emfcamp/TiDAL-Hardware/tilda6/manufacturing-data-expansion/expansion-back.png

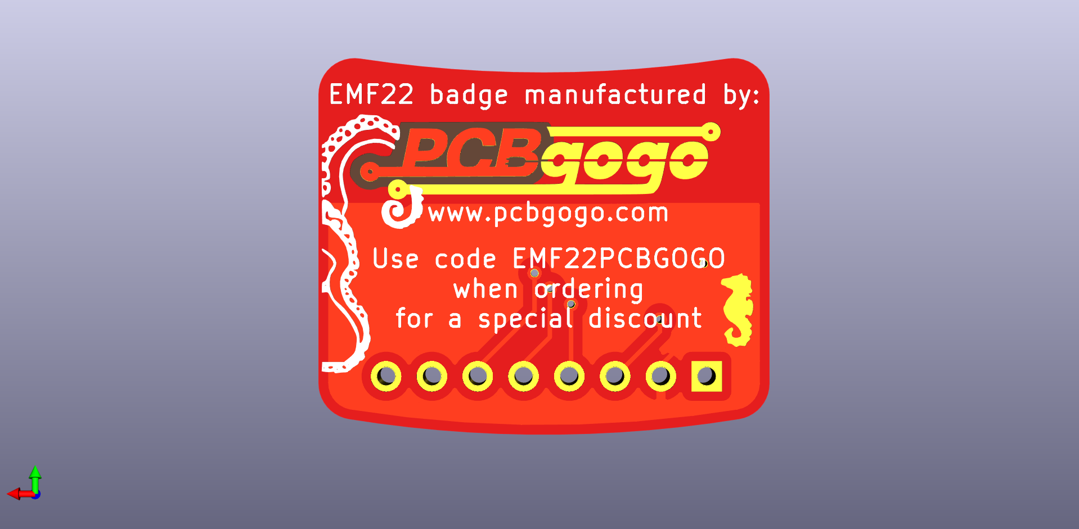
tilda6/manufacturing-data-expansion/expansion-back.png
