emfcamp/TiDAL-Hardware/tilda6/manufacturing-data-expansion/expansion-front.png

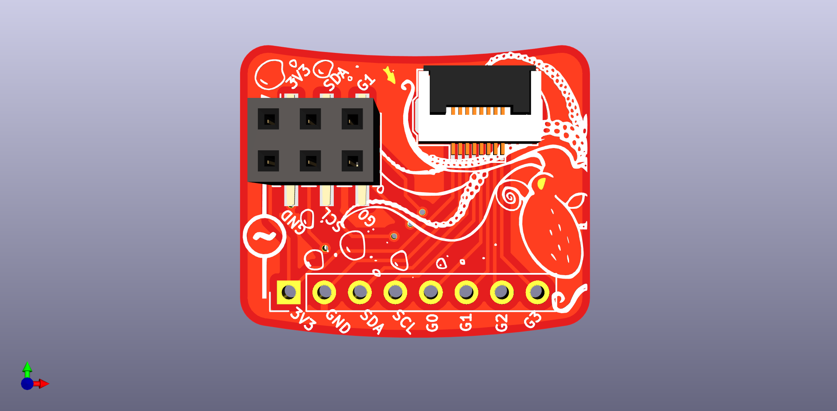
tilda6/manufacturing-data-expansion/expansion-front.png
