emfcamp/TiDAL-Hardware/art/bottom.png

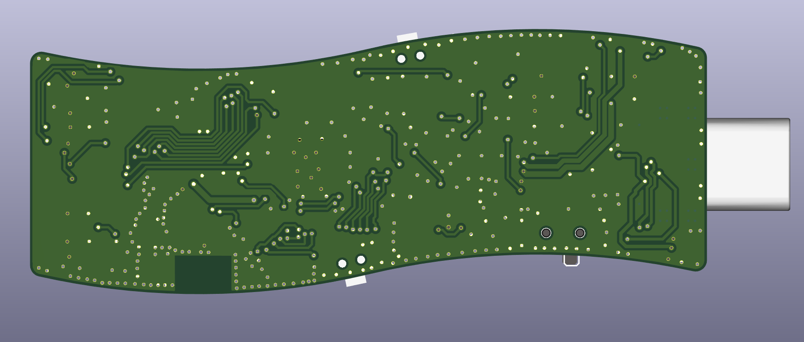
art/bottom.png
