emfcamp/TiDAL-Hardware/art/features/bot-front/bot-front-mask.png

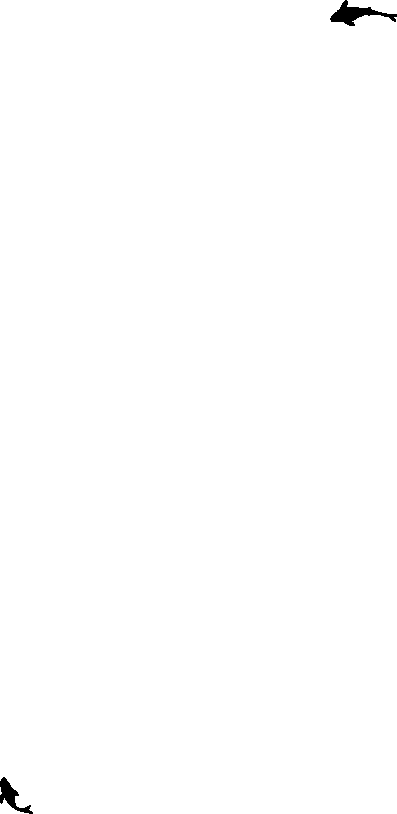
art/features/bot-front/bot-front-mask.png
