emfcamp/TiDAL-Hardware/art/features/bot-front/bot-front-silk.png

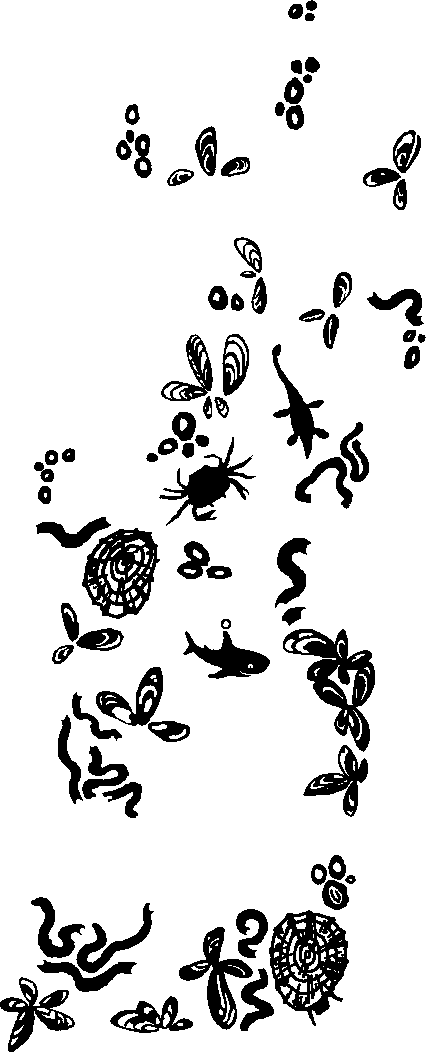
art/features/bot-front/bot-front-silk.png
