emfcamp/TiDAL-Hardware/art/features/bot-reverse/bf2.png

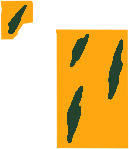
art/features/bot-reverse/bf2.png
