emfcamp/TiDAL-Hardware/art/features/bot-reverse/bf3.png

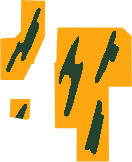
art/features/bot-reverse/bf3.png
