emfcamp/TiDAL-Hardware/art/features/bot-reverse/bf4.png

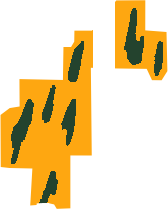
art/features/bot-reverse/bf4.png
