emfcamp/TiDAL-Hardware/art/features/bot-reverse/bf6.png

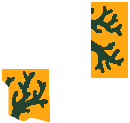
art/features/bot-reverse/bf6.png
