emfcamp/TiDAL-Hardware/art/features/bot-reverse/bf7.png

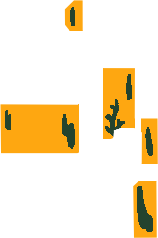
art/features/bot-reverse/bf7.png
