emfcamp/TiDAL-Hardware/art/features/bot-reverse/bot-reverse-mask.png

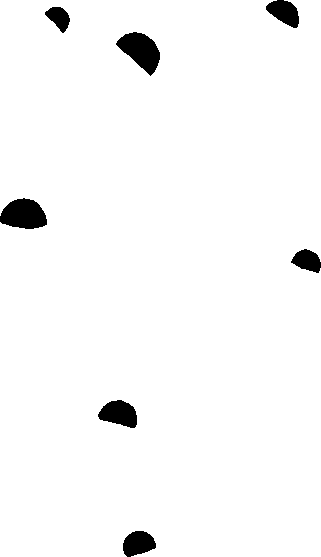
art/features/bot-reverse/bot-reverse-mask.png
