emfcamp/TiDAL-Hardware/art/features/bot-reverse/bot-reverse-silk.png

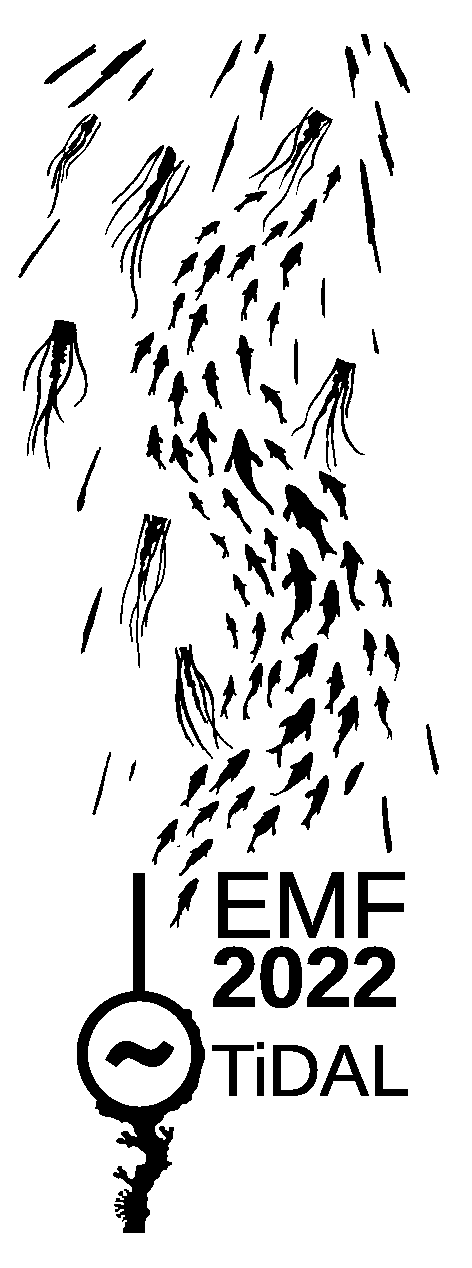
art/features/bot-reverse/bot-reverse-silk.png
