emfcamp/TiDAL-Hardware/art/features/top-front/f3.png

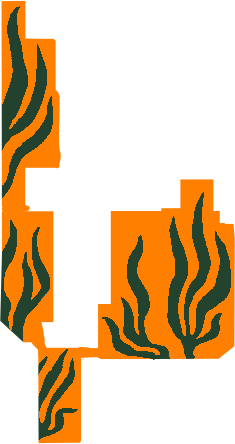
art/features/top-front/f3.png
