emfcamp/TiDAL-Hardware/art/features/top-front/front-silk.png

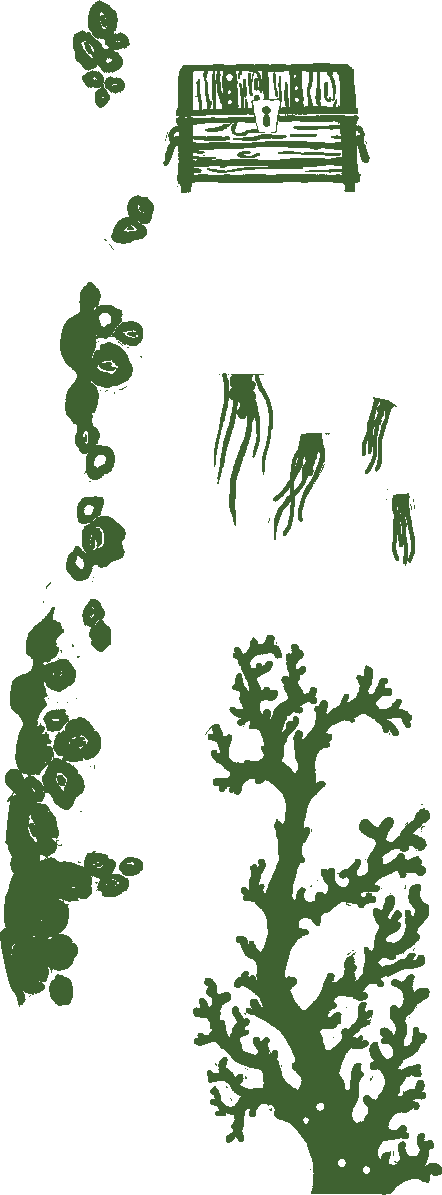
art/features/top-front/front-silk.png
