emfcamp/TiDAL-Hardware/art/features/top-front/top-front-image.png

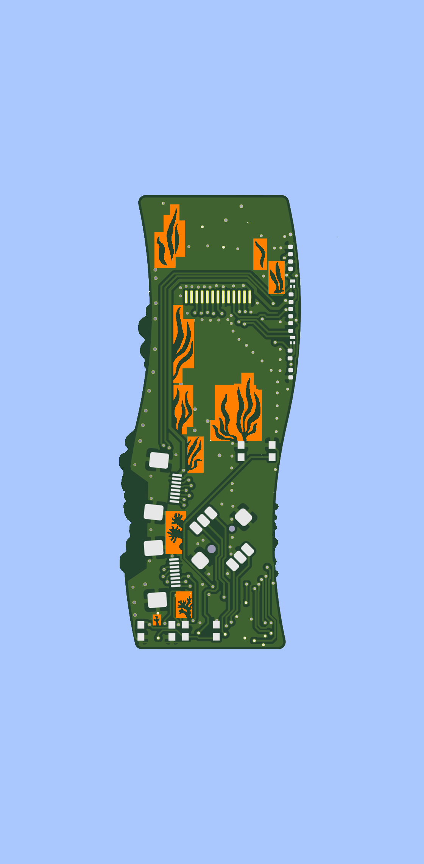
art/features/top-front/top-front-image.png
