emfcamp/TiDAL-Hardware/art/features/top-front/top-front-mask.png

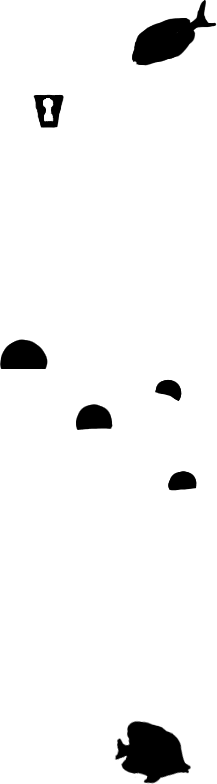
art/features/top-front/top-front-mask.png
