emfcamp/TiDAL-Hardware/art/features/top-front/topfront-silk.png

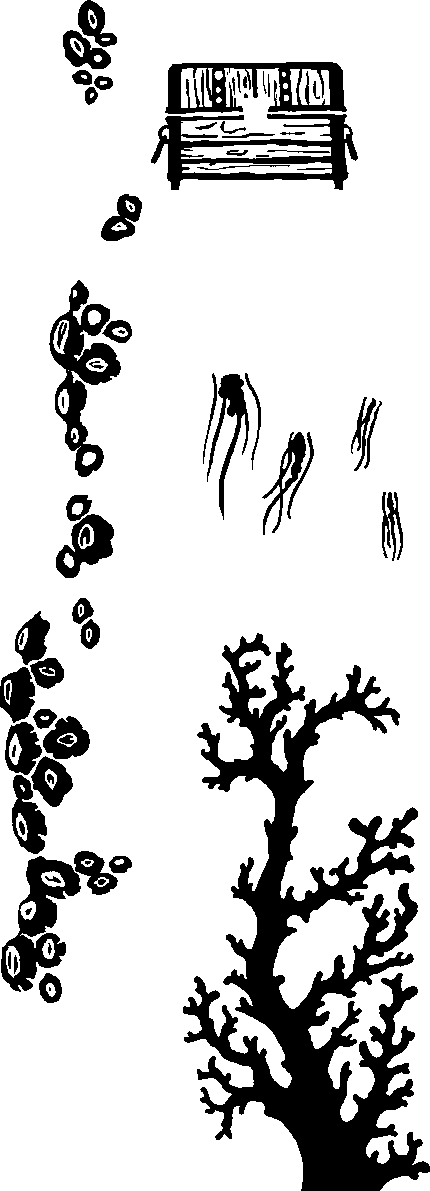
art/features/top-front/topfront-silk.png
