emfcamp/TiDAL-Hardware/art/features/top-reverse/top-reverse-mask.png

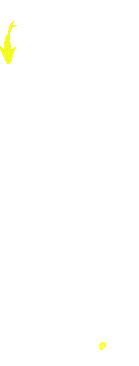
art/features/top-reverse/top-reverse-mask.png
