emfcamp/TiDAL-Hardware/art/features/top-reverse/top-reverse-silk.png

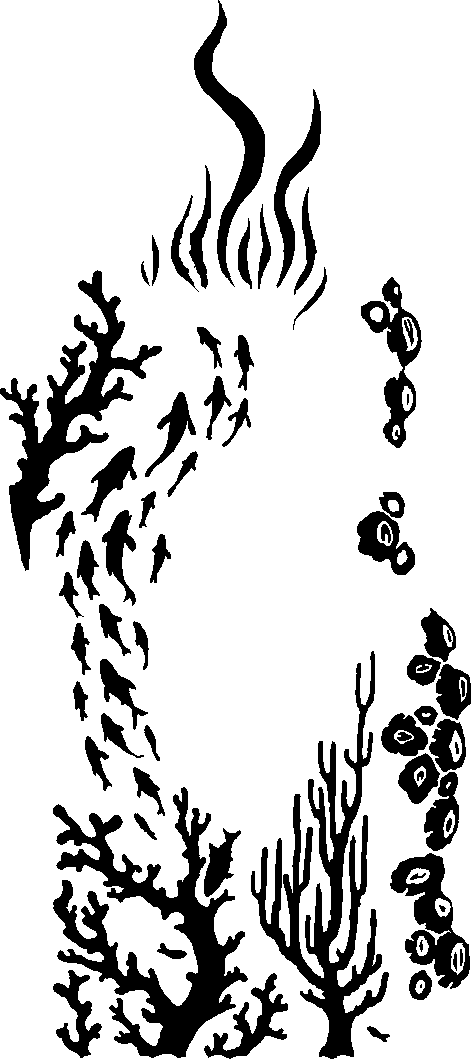
art/features/top-reverse/top-reverse-silk.png
