emfcamp/TiDAL-Hardware/art/features/top-reverse/tr1.png

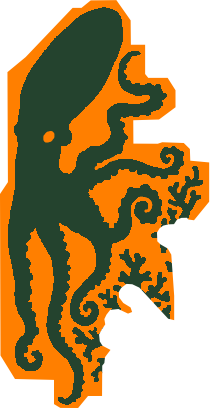
art/features/top-reverse/tr1.png
