emfcamp/TiDAL-Hardware/art/overview.png

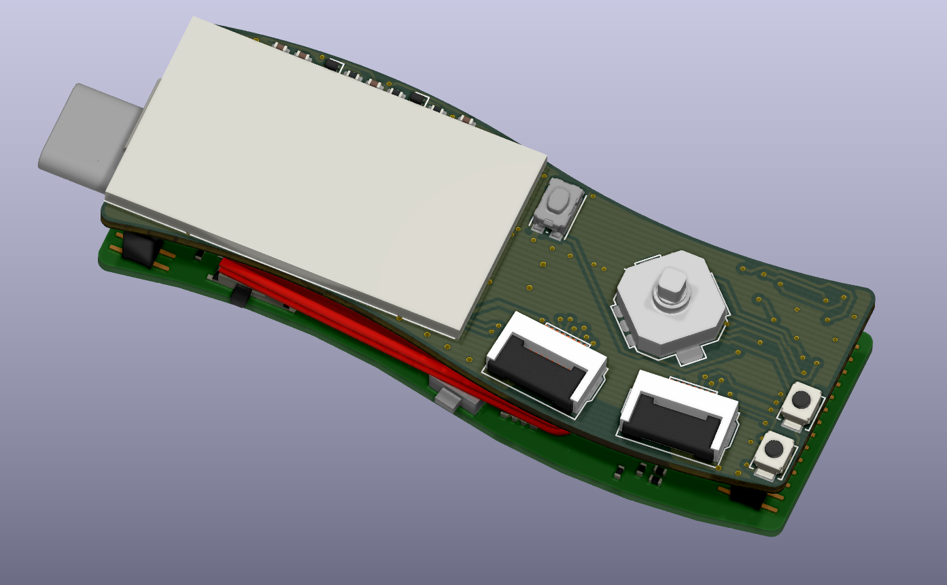
art/overview.png
