emfcamp/TiDAL-Hardware/art/tilda6-bot-noparts-reverse.png

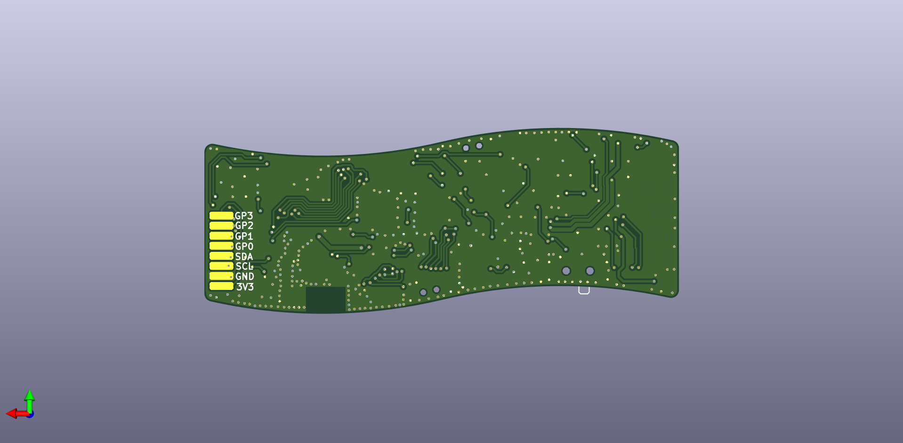
art/tilda6-bot-noparts-reverse.png
