emfcamp/TiDAL-Hardware/art/tilda6-bot-noparts.png

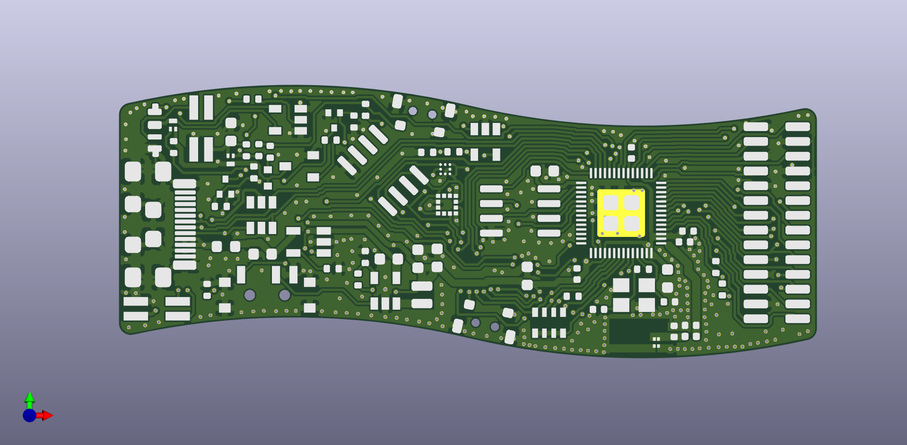
art/tilda6-bot-noparts.png
