emfcamp/TiDAL-Hardware/art/tilda6-bot-nosilk.png

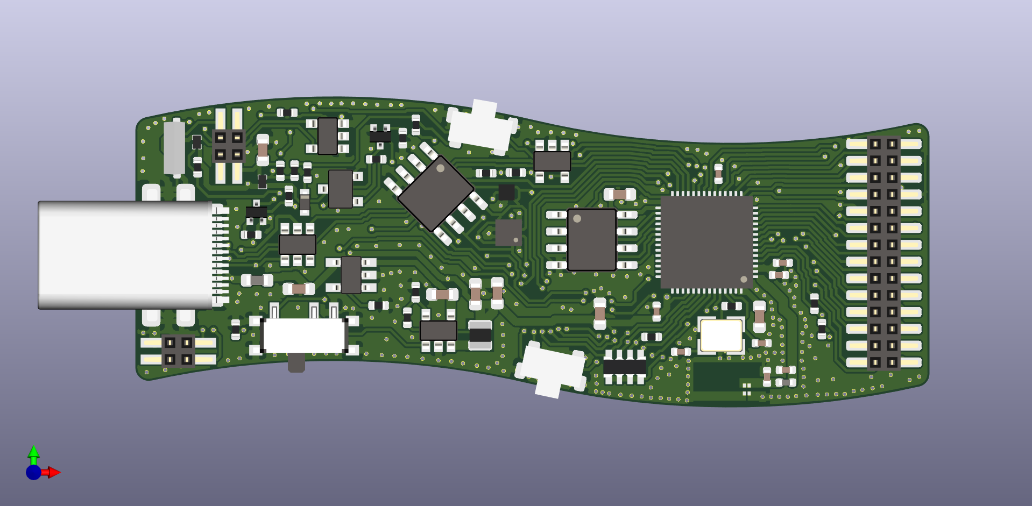
art/tilda6-bot-nosilk.png
