emfcamp/TiDAL-Hardware/art/tilda6-bottomboard-botside-annotated-mask.png

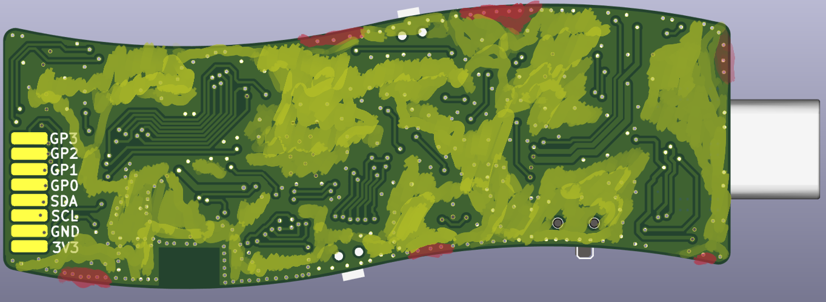
art/tilda6-bottomboard-botside-annotated-mask.png
