emfcamp/TiDAL-Hardware/art/tilda6-bottomboard-botside-annotated.png

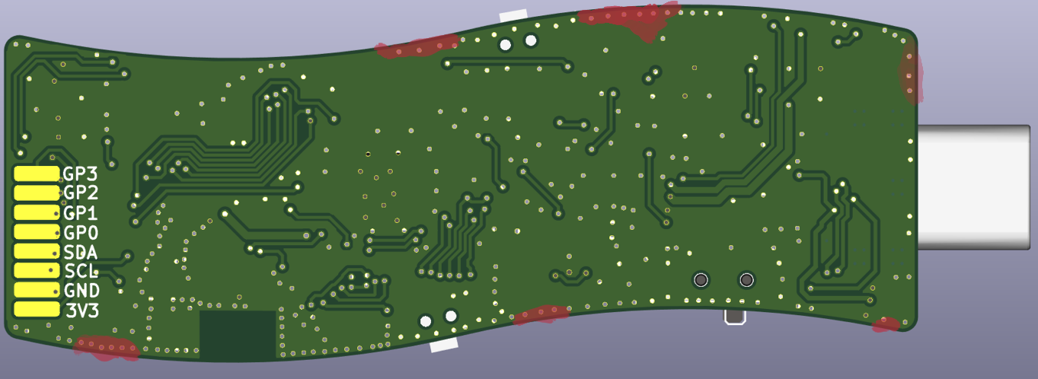
art/tilda6-bottomboard-botside-annotated.png
