emfcamp/TiDAL-Hardware/art/tilda6-bottomboard-topside-annotated-mask.png

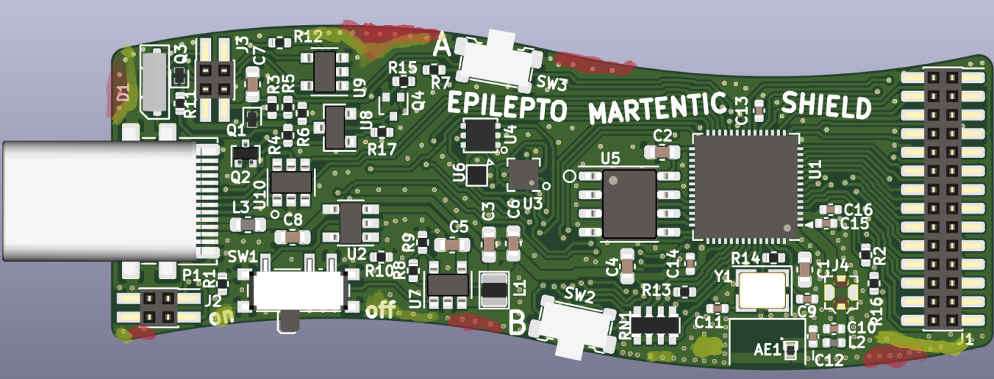
art/tilda6-bottomboard-topside-annotated-mask.png
