emfcamp/TiDAL-Hardware/art/tilda6-top-noparts-reverse.png

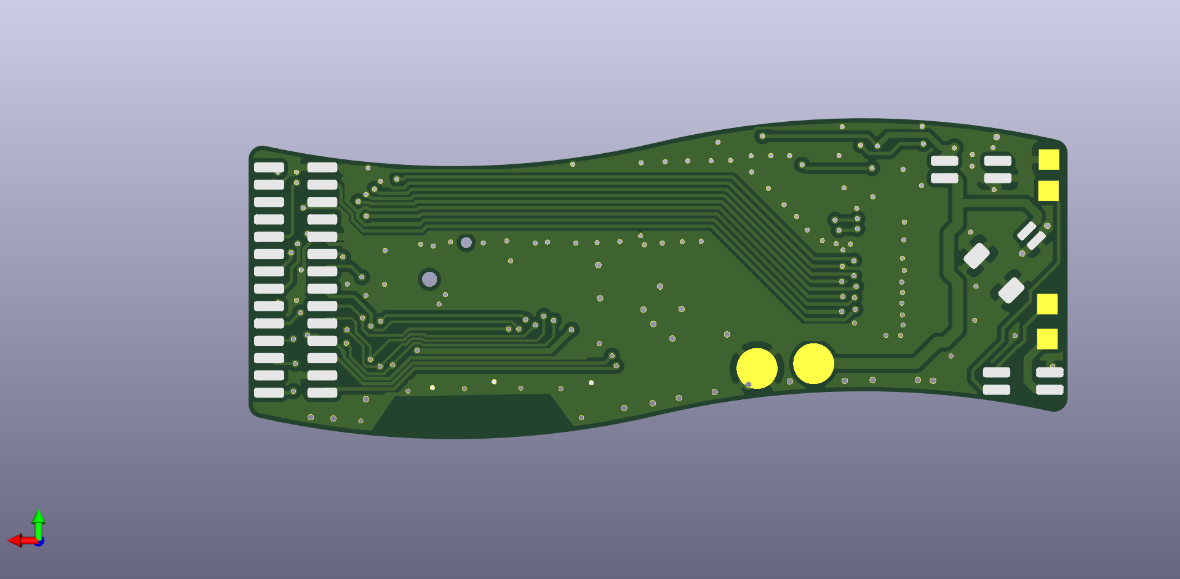
art/tilda6-top-noparts-reverse.png
