emfcamp/TiDAL-Hardware/art/tilda6-top-noparts.png

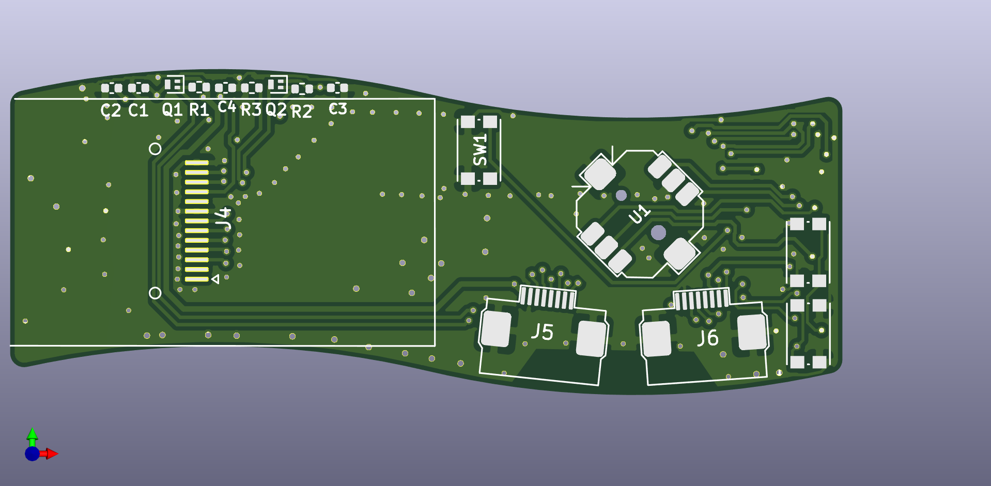
art/tilda6-top-noparts.png
