emfcamp/TiDAL-Hardware/art/tilda6-topboard-botside-annotated-mask.png

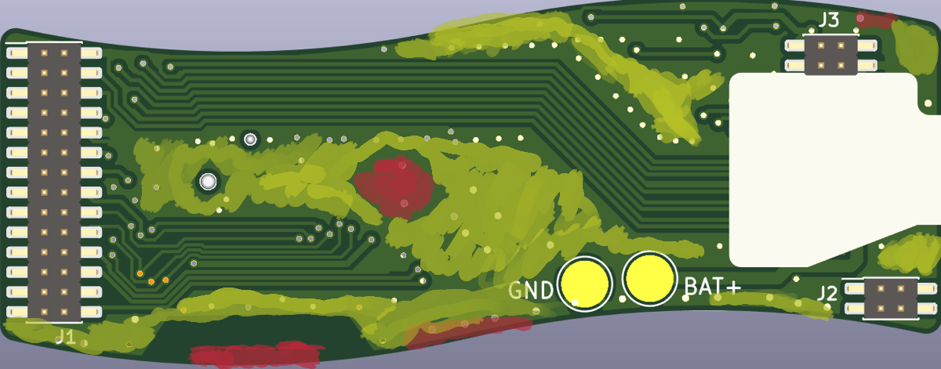
art/tilda6-topboard-botside-annotated-mask.png
