emfcamp/TiDAL-Hardware/art/tilda6-topboard-botside-annotated.png

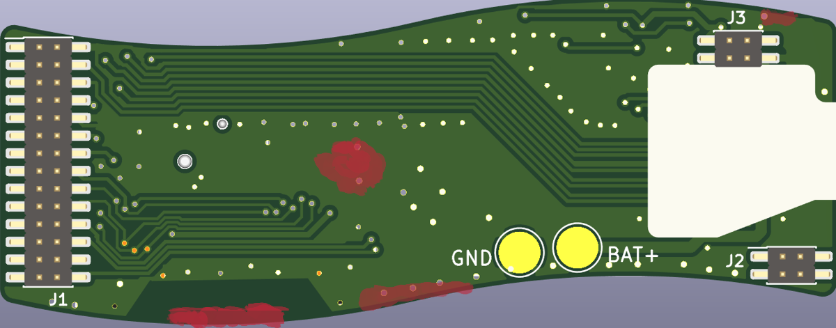
art/tilda6-topboard-botside-annotated.png
