emfcamp/TiDAL-Hardware/art/tilda6-topboard-topside-annotated-mask.png

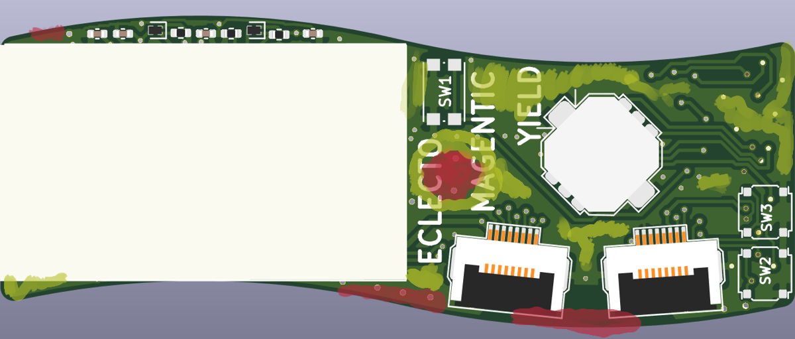
art/tilda6-topboard-topside-annotated-mask.png
