emfcamp/TiDAL-Hardware/art/top.png

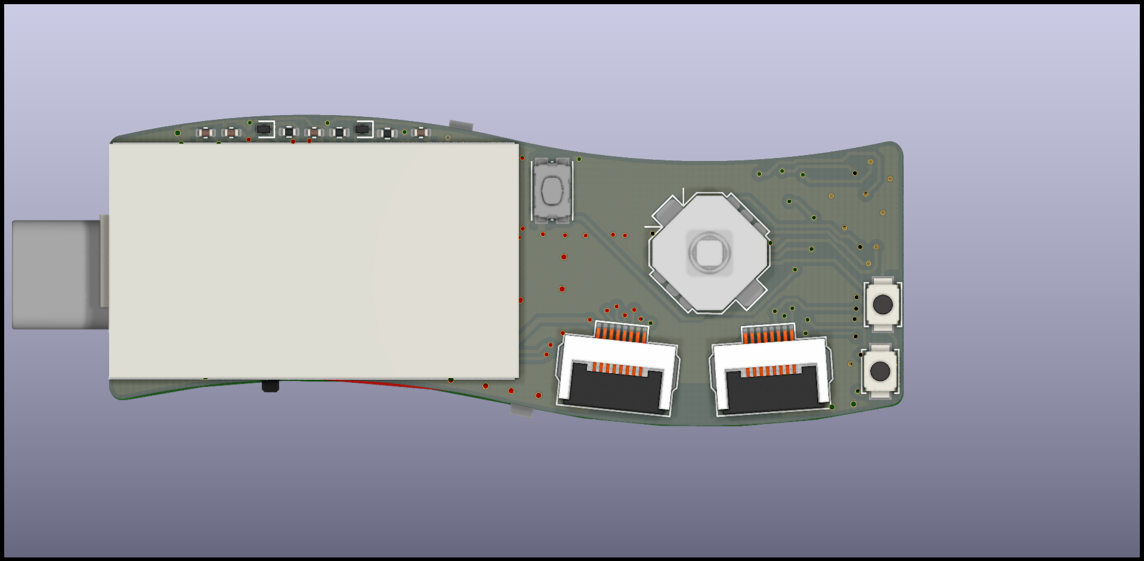
art/top.png
