emfcamp/TiDAL-Hardware/tilda6/tilda6-BOM.xlsx

Sheet: BOM costing
top board
RD | Value | Desc | fp | Q | Notes | MN | MPN | DPN | DN | Price | EP | Avail | URL
> C1, C2 | 1u | 25V X5R | Capacitor_SMD:C_0402_1005Metric | 2 |  |  |  |  |  | 0.02 | 0.04 |  | https://lcsc.com/product-detail/Multilayer-Ceramic-Capacitors-MLCC-SMD-SMT_SANYEAR-C0402X5R105K250NT_C466612.html
C3, C4 | 10n | 50V X7R | Capacitor_SMD:C_0402_1005Metric | 2 |  |  |  |  |  | 0.001 | 0.002 |  | https://lcsc.com/product-detail/Multilayer-Ceramic-Capacitors-MLCC-SMD-SMT_Murata-Electronics-GRM155R71H103KA88D_C77019.html
J1 | Conn_02x14_Odd_Even | 2x14 1.27mm header | Connector_PinHeader_1.27mm:PinHeader_2x14_P1.27mm_Vertical_SMD | 1 |  |  |  |  |  | 0.2 | 0.2 |  | https://en.maritex.com.pl/connectors/pin_headers_and_sockets/pin_headers_and_sockets_1_27mm_pitch/pin_headers_double_row_smt_1_27_mm_pitch/plhtd28s-tr-cv.html
> J2, J3 | Conn_02x02_Odd_Even | 2x2 1.27mm header | Connector_PinHeader_1.27mm:PinHeader_2x02_P1.27mm_Vertical_SMD | 2 |  |  |  |  |  | 0.07 | 0.14 |  | https://www.ebay.com/itm/163476853298
J4 | Conn_01x13 |  | corelib:ER-TFT-1.14-reverse | 1 |  |  |  |  |  | 2.95 | 2.95 |  | https://www.buydisplay.com/1-14-inch-tft-lcd-display-ips-panel-screen-135x240-for-smart-watch
> J5, J6 | Conn_01x08 |  | tilda6:XUNPU_FPC-05F-8PH20 | 2 |  | Xunpu | FPC-05F-8PH20 | C2856797 | LCSC | 0.06 | 0.12 | 12920 | https://lcsc.com/product-detail/FFC-FPC-Connectors_XUNPU-FPC-05F-8PH20_C2856797.html
J7 | SM02B-SRSS |  | Connector_JST:JST_SH_SM02B-SRSS-TB_1x02-1MP_P1.00mm_Horizontal | 1 |  | JST | SM02B-SRSS | C160402 | LCSC | 0.09 | 0.09 | 203300 | https://lcsc.com/product-detail/Wire-To-Board-Wire-To-Wire-Connector_JST-Sales-America-SM02B-SRSS-TB-LF-SN_C160402.html
> Q1, Q2 | LP0404N3T5G |  | Package_TO_SOT_SMD:SOT-883 | 2 |  | LRC | LP0404N3T5G | C172433 | LCSC | 0.03 | 0.06 | 31420 | https://lcsc.com/product-detail/MOSFETs_LRC-LP0404N3T5G_C172433.html
> R1, R2 | 10k | 1% Resistor 0402 | Resistor_SMD:R_0402_1005Metric | 2 |  |  |  |  |  | 0.001 | 0.002
R3 | 47R | 1% Resistor 0402 | Resistor_SMD:R_0402_1005Metric | 1 |  |  |  |  |  | 0.001 | 0.001 |  | https://lcsc.com/product-detail/Chip-Resistor-Surface-Mount_UNI-ROYAL-Uniroyal-Elec-0402WGF470JTCE_C25118.html
SW1, SW2, SW3 | SW_Push |  | Button_Switch_SMD:SW_Push_1P1T_NO_CK_KMR2 | 3 |  | XKB | TS-1185EC-C-D-B | C318893 | LCSC | 0.04 | 0.12 |  | https://lcsc.com/product-detail/Tactile-Switches_XKB-Connectivity-TS-1185EC-C-D-B_C318893.html
U1 | 5-WAY-JOYSTICK |  | tilda6:JOYSTICK-5-WAY | 1 | alt: https://lcsc.com/product-detail/Multi-Directional-Switches_Korean-Hroparts-Elec-K1-5202UA-02_C145900.html | XKB | TM-4175-B-B | C465996 | LCSC | 0.37 | 0.37 |  | https://lcsc.com/product-detail/Multi-Directional-Switches_XKB-Connectivity-TM-4175-B-B_C465996.html
 |  |  |  |  |  |  |  |  |  | total | 4.095
bot board
RD | Value | Desc | fp | Q | Notes | MN | MPN | DPN | DN | Price | EP | Avail | URL
AE1 | 2450AT07A0100 |  | tilda6:2450AT07A0100 | 1 |  | Johanson Technology Inc. | 2450AT07A0100T | 712-1572-1-ND | Digikey | 0.28 | 0.28 |  | https://octopart.com/search?q=2450AT07A0100&currency=USD&specs=0
> C1-C8 | 4.7u | 25V X5R | Capacitor_SMD:C_0603_1608Metric | 8 |  |  |  |  |  | 0.03 | 0.24 |  | https://lcsc.com/product-detail/Multilayer-Ceramic-Capacitors-MLCC-SMD-SMT_TDK-C1608X5R1E475KT000E_C76615.html
C9, C11 | 15pF | C0G | Capacitor_SMD:C_0402_1005Metric | 2 |  |  |  |  |  | 0.001 | 0.002 |  | https://lcsc.com/product-detail/Multilayer-Ceramic-Capacitors-MLCC-SMD-SMT_TDK-CGA2B2C0G1H150JT0Y0F_C338103.html
C10, C12 | DNP | DNP |  | 2 |  |  |  |  |  | 0 | 0
C13, C14, C15 | 1u | 25V X5R | Capacitor_SMD:C_0402_1005Metric | 3 |  |  |  |  |  | 0.001 | 0.003 |  | https://lcsc.com/product-detail/Multilayer-Ceramic-Capacitors-MLCC-SMD-SMT_SANYEAR-C0402X5R105K250NT_C466612.html
C16 | 10n | 50V X7R | Capacitor_SMD:C_0402_1005Metric | 1 |  |  |  |  |  | 0.001 | 0.001 |  | https://lcsc.com/product-detail/Multilayer-Ceramic-Capacitors-MLCC-SMD-SMT_Murata-Electronics-GRM155R71H103KA88D_C77019.html
C17 | 8.2pF | C0G | Inductor_SMD:C_0402_1005Metric | 1 |  |  |  |  |  | 0.001 | 0.001
D1 | WS2812B-SIDE-A |  | Tilda-MKV:SK6812SIDE-A | 1 |  | Shenzhen Normand Electronic Co.,Ltd | SK6812-SIDE-A |  |  | 0.07 | 0.07 | lots | https://aliexpress.com/item/32968351207.html
D2 | 1N4148WT | Diode SOD-523 | Diode_SMD:D_SOD-523 | 1 |  | Shikues | 1N4148WT | C110222 | LCSC | 0.0105 | 0.0105 |  | https://lcsc.com/product-detail/Switching-Diode_Shikues-1N4148WT_C110222.html
J1 | Conn_02x14_Odd_Even | 2x14 1.27mm socket | Connector_PinSocket_1.27mm:PinSocket_2x14_P1.27mm_Vertical_SMD | 1 |  |  |  |  |  | 0.7 | 0.7 |  | https://en.maritex.com.pl/connectors/pin_headers_and_sockets/pin_headers_and_sockets_1_27mm_pitch/female_sockets_double_row_smt_1_27_mm_pitch/pbhtd28spp.html
> J2, J3 | Conn_02x02_Odd_Even | 2x2 1.27mm socket | Connector_PinSocket_1.27mm:PinSocket_2x02_P1.27mm_Vertical_SMD | 2 |  |  |  |  |  | 0.1 | 0.2 |  | https://www.ebay.com/itm/163476832058
L1 | MHCHL201610A-2R2M-Q8A |  | Inductor_SMD:L_Taiyo-Yuden_MD-2020 | 1 |  | Chilisin Elec | MHCHL201610A-2R2M-Q8A | C329567 | LCSC | 0.06 | 0.06 |  | https://lcsc.com/product-detail/Power-Inductors_Chilisin-Elec-MHCHL201610A-2R2M-Q8A_C329567.html
L3 | BLM18PG181SN1D |  | Inductor_SMD:L_0603_1608Metric | 1 |  | Murata Electronics | BLM18PG181SN1D | C82850 | LCSC | 0.007 | 0.007 |  | https://lcsc.com/product-detail/Ferrite-Beads_Murata-Electronics-BLM18PG181SN1D_C82850.html
P1 | USB_C_Plug |  | corelib:UTC009-C-vias | 1 |  | Palconn | UTC-009-C |  |  | 0.32 | 0.32 |  | https://chbpalconn.en.made-in-china.com/product/WKnmGUSCJYre/China-USB3-0-Type-C-Connector-12-Pin-SMD-Male-Connector-Contact-Resistance-40mohm-Current-Rating-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
Q1, Q3 | LP0404N3T5G |  | Package_TO_SOT_SMD:SOT-883 | 2 |  | LRC | LP0404N3T5G | C172433 | LCSC | 0.03 | 0.06 |  | https://lcsc.com/product-detail/MOSFETs_LRC-LP0404N3T5G_C172433.html
Q2, Q4 | 2SK3019 |  | Package_TO_SOT_SMD:SOT-416 | 1 |  | Tak Cheong | 2SK3019 | C261283 | LCSC | 0.02 | 0.02 |  | https://www.lcsc.com/product-detail/MOSFETs_Tak-Cheong-2SK3019_C261283.html
R1 | 5.1k | 1% Resistor 0402 | Resistor_SMD:R_0402_1005Metric | 1 |  |  |  |  |  | 0.001 | 0.001 |  | https://lcsc.com/product-detail/Chip-Resistor-Surface-Mount_UNI-ROYAL-Uniroyal-Elec-0402WGF5101TCE_C25905.html
R3, R16 | 267k | 1% Resistor 0402 | Resistor_SMD:R_0402_1005Metric | 2 |  |  |  |  |  | 0.001 | 0.002
R2, R4, R10, R15 | 10k | 1% Resistor 0402 | Resistor_SMD:R_0402_1005Metric | 4 |  |  |  |  |  | 0.001 | 0.004
R5, R6, R9, R11, R18, R20 | 100k | 1% Resistor 0402 | Resistor_SMD:R_0402_1005Metric | 6 |  |  |  |  |  | 0.001 | 0.006
R7 | 1M | 1% Resistor 0402 | Resistor_SMD:R_0402_1005Metric | 1 |  |  |  |  |  | 0.001 | 0.001
R8 | 453k | 1% Resistor 0402 | Resistor_SMD:R_0402_1005Metric | 1 |  |  |  |  |  | 0.001 | 0.001
R19 | 66.5k | 1% Resistor 0402 | Resistor_SMD:R_0402_1005Metric | 1 |  |  |  |  |  | 0.001 | 0.001
R12, R17 | 1k | 1% Resistor 0402 | Resistor_SMD:R_0402_1005Metric | 2 |  |  |  |  |  | 0.001 | 0.002
R13 | 499R | 1% Resistor 0402 | Resistor_SMD:R_0402_1005Metric | 1 |  |  |  |  |  | 0.001 | 0.001
R14 | 0R | Resistor 0402 | Resistor_SMD:R_0402_1005Metric | 1 |  |  |  |  |  | 0.001 | 0.001
RN1 | 4.7k | 5% RN 1206 (4x0603) | Resistor_SMD:R_Array_Convex_4x0603 | 1 |  | YAGEO | YC164-JR-074K7L | C327044 | LCSC | 0.01 | 0.01 |  | https://lcsc.com/product-detail/Resistor-Networks-Arrays_YAGEO-YC164-JR-074K7L_C327044.html
SW1 | SW_SPDT |  | Button_Switch_SMD:SW_SPDT_PCM12 | 1 |  | SHOU HAN | MSK12C02 | C431540 | LCSC | 0.04 | 0.04 |  | https://lcsc.com/product-detail/Slide-Switches_SHOU-HAN-MSK12C02_C431540.html
> SW2, SW3 | SW_SPST |  | tilda6:sidebutton-1TS003B-1400-3500A-CT | 2 |  | Hongyuan Precision | 1TS003B-1400-3500A-CT | C319392 | LCSC | 0.03 | 0.06 |  | https://lcsc.com/product-detail/Tactile-Switches_HYP-Hongyuan-Precision-1TS003B-1400-3500A-CT_C319392.html
U1 | ESP32-S3N8 |  | tilda6:QFN-56-1EP_7x7mm_P0.4mm_EP4.1x4.1mm | 1 | sponsored | Espressif | ESP32-S3N8 |  |  | 0 | 0
U2 | LTH7R. |  | Package_TO_SOT_SMD:TSOT-23-5 | 1 |  | Shenzhen Fuman Elec | LTH7R. | C841234 | LCSC | 0.06 | 0.06 |  | https://lcsc.com/product-detail/Battery-Management-ICs_Shenzhen-Fuman-Elec-LTH7R_C841234.html
U3 | QMA7981 |  | Package_LGA:LGA-12_2x2mm_P0.5mm | 1 |  | QST | QMA7981 | C457290 | LCSC | 0.4 | 0.4 |  | https://lcsc.com/product-detail/Motion-Sensors-Accelerometers_QST-QMA7981_C457290.html
U4 | ATECC108A-SSHDA | cryptographic storage ic | Package_SO:SOIC-8_3.9x4.9mm_P1.27mm | 1 |  | Microchip | ATECC108A-SSHDA-T | 1020036-ATECC108A-SSHDA-T | Winsource | 2.32 | 2.32 |  | https://www.win-source.net/microchip-technology-atecc108a-sshda-t.html
U5 | ESP-PSRAM64 |  | Package_SO:SOIC-8_3.9x4.9mm_P1.27mm | 1 | sponsored | Espressif | ESP-PSRAM64 |  |  | 0 | 0
U6 | QMC7983 |  | tilda6:QMC7983 | 1 |  | QST | QMC7983 | C310612 | LCSC | 0.29 | 0.29 |  | https://lcsc.com/product-detail/Others_QST-QMC7983_C310612.html
U7 | M3406-ADJ |  | Package_TO_SOT_SMD:SOT-23-5 | 1 |  | Xi’an Aerosemi Tech | M3406-ADJ | C83224 | LCSC | 0.05 | 0.05 |  | https://lcsc.com/product-detail/DC-DC-Converters_XI-AN-Aerosemi-Tech-M3406-ADJ_C83224.html
U8 | SSP61CC3002MR |  | Package_TO_SOT_SMD:SOT-23 | 1 |  | Shanghai Siproin Microelectronics | SSP61CC3002MR | C277924 | LCSC | 0.04 | 0.04 | 225000 | https://lcsc.com/product-detail/Monitors-Reset-Circuits_Shanghai-Siproin-Microelectronics-SSP61CC3002MR_C277924.html
U9 | SN74LVC1G125DBVR |  | Package_TO_SOT_SMD:SOT-23-5 | 1 |  | Texas Instruments | SN74LVC1G125DBVR | C23654 | LCSC | 0.05 | 0.05 |  | https://lcsc.com/product-detail/Buffers-Drivers_Texas-Instruments-SN74LVC1G125DBVR_C23654.html
U10 | ESDU5V0H4 |  | Package_TO_SOT_SMD:SOT-23-6 | 1 |  | Changjiang Electronics Tech | ESDU5V0H4 | C84837 | LCSC | 0.05 | 0.05 |  | https://lcsc.com/product-detail/ESD-Protection-Devices_Changjiang-Electronics-Tech-CJ-ESDU5V0H4_C84837.html
U11 | LMV321-TR |  | Package_TO_SOT_SMD:SOT-23-5 | 1 |  | Gainsil | LMV321-TR | C362273 | LCSC | 0.0475 | 0.0475 |  | https://lcsc.com/product-detail/Operational-Amplifier_Gainsil-LMV321-TR_C362273.html
Y1 | X322540MPB4SI | 40MHz xtal | Crystal:Crystal_SMD_TXC_7M-4Pin_3.2x2.5mm | 1 |  | Yangxing Tech | X322540MPB4SI | C9010 | LCSC | 0.061 | 0.061 |  | https://lcsc.com/product-detail/Crystals_Yangxing-Tech-X322540MPB4SI_C9010.html
 |  |  |  |  |  |  |  |  |  |  | 0
 |  |  |  |  |  |  |  |  |  | total | 5.473
 |  |  |  |  |  |  |  |  |  | BOM cost | 9.568
PCBs
 |  | top PCB |  | 1 | sponsored |  |  |  |  | 0 | 0
 |  | bot PCB |  | 1 | sponsored |  |  |  |  | 0 | 0
 |  | flex expansion |  | 1 |  |  |  |  |  | 0 | 0
 |  |  |  |  |  |  |  |  |  | PCB cost | 0
Other parts
 |  | battery |  | 1 |  |  |  |  |  | 1.16 | 1.16
 |  | assembly |  | 1 | sponsored |  |  |  |  | 0 | 0
 |  | lanyard |  | 1 |  |  |  |  |  | 0.25 | 0.25
 |  |  |  |  |  |  |  |  |  | total | 1.41
 |  |  |  |  |  |  |  |  |  | USD total | 10.978
 |  |  |  |  |  |  |  |  |  | GBP total | 8.45306 | /unit
 |  |  |  |  |  |  |  |  |  | 3500 units | 29585.71 | GBP

Sheet: Budgeting
Main items | Description | Note | All prices in USD |  | Needed | Stock |  | Display 1 | Display 2 |  | URL
LCD: |  |  | Price
Display 1 | 0.96" 80x160 |  | 2.8 |  | 1 | plenty |  | 2.8 | 0 |  | https://www.szallvision.com/0-96transmissivetftdisplay
Display 2 | 1.14" 135x240 |  | 6.3 |  | 1 | plenty |  | 0 | 6.3 |  | https://www.szallvision.com/1-14-transmissive-tft-display
Battery:
Battery | 3.5x20x26mm, 130mAh |  | 1.5 |  | 1 | ? |  | 1.5 | 1.5 |  | http://www.sz-battery.com/lithium-polymer-battery/9mah-30mah/240.html
PCBs:
PCB 1 | 2 layer 24x60mm, 0.8mm |  | 0.25 |  | 1 | plenty |  | 0.25 | 0.25
PCB 2 | same |  | 0.25 |  | 1 | plenty |  | 0.25 | 0.25
FPC | 50x10mm, black, PI stiffener, adhesive |  | 0.31 |  | 1 | plenty |  | 0.31 | 0.31
Switches:
side switch 1/2 | side-actuated tactile switch |  | 0.03 |  | 2 | 30k |  | 0.06 | 0.06 |  | https://lcsc.com/product-detail/Tactile-Switches_HYP-Hongyuan-Precision-1TS003B-1400-3500A-CT_C319392.html
top switch | top-actuated tactile switch |  | 0.03 |  | 1 | 81k |  | 0.03 | 0.03 |  | https://lcsc.com/product-detail/Tactile-Switches_XKB-Connectivity-TS-1185EC-C-D-B_C318893.html
joystick | 5-way joypad |  | 0.48 |  | 1 | 1k |  | 0.48 | 0.48 |  | https://lcsc.com/product-detail/Multi-Directional-Switches_ALPSALPINE-SKRVABE010_C370964.html
on/off | slide switch |  | 0.03 |  | 1 | 11k |  | 0.03 | 0.03 |  | https://lcsc.com/product-detail/Slide-Switches_SHOU-HAN-MSK12C02_C431540.html
ICs:
MCU | ESP32-S3 MINI module |  | 0 | sponsored | 1 | ? |  | 0 | 0
Accelerometer | 3-axis MEMS accelerometer |  | 0.42 |  | 1 | 18k |  | 0.42 | 0.42 |  | https://lcsc.com/product-detail/Motion-Sensors-Accelerometers_ROHM-Semicon-KXTJ3-1057_C442603.html
LED | SK6812 SIDE A |  | 0.07 |  | 1 | plenty |  | 0.07 | 0.07 |  | https://de.aliexpress.com/item/32968351207.html
Identity IC | A1006UK/TA1NXZ |  | 0.7 |  | 1 | 8k |  | 0.7 | 0.7 |  | https://www.mouser.de/ProductDetail/NXP-Semiconductors/A1006UK-TA1NXZ?qs=BZBei1rCqCC9Hw0Z6d8oNA==
Battery charger |  |  | 0.08 |  | 1 | plenty |  | 0.08 | 0.08 |  | https://lcsc.com/product-detail/Battery-Management-ICs_Shenzhen-Fuman-Elec-9017R_C841235.html
DCDC |  |  | 0.09 |  | 1 | plenty |  | 0.09 | 0.09 |  | https://lcsc.com/product-detail/DC-DC-Converters_XI-AN-Aerosemi-Tech-MT3520B_C2684933.html
Magnetometer | 3-axis magnetometer |  | 0.14 |  | 1 | 1k |  | 0.14 | 0.14 |  | https://lcsc.com/product-detail/Magnetic-Sensors_QST-QMC6308_C462705.html
Connectors:
USB-C |  |  | 0.32 | maybe sponsored? | 1 |  |  | 0.32 | 0.32
Bottom 2x2 |  |  | 0.097 |  | 2 | ? |  | 0.194 | 0.194 |  | https://www.ebay.com/itm/163476832058
Top 2x2 |  |  | 0.07 |  | 2 | ? |  | 0.14 | 0.14 |  | https://www.ebay.com/itm/163476853298
Bottom 2x14 |  |  | 0.2 |  | 1 | 3.7k |  | 0.2 | 0.2 |  | https://en.maritex.com.pl/connectors/pin_headers_and_sockets/pin_headers_and_sockets_1_27mm_pitch/pin_headers_double_row_smt_1_27_mm_pitch/plhtd28s-tr-cv.html
Top 2x14 |  |  | 0.7 |  | 1 | 2.1k |  | 0.7 | 0.7 |  | https://en.maritex.com.pl/connectors/pin_headers_and_sockets/pin_headers_and_sockets_1_27mm_pitch/female_sockets_double_row_smt_1_27_mm_pitch/pbhtd28spp.html
Battery connector | SH series |  | 0.1 |  | 1 | 2k |  | 0.1 | 0.1 |  | https://lcsc.com/product-detail/Wire-To-Board-Wire-To-Wire-Connector_CJT-Changjiang-Connectors-A1002WR-S-2P_C239520.html
Expansion connector | 8pin 0.5mm FPC | 1 | 0.06 |  | 2 | 30k |  | 0.12 | 0.12 |  | https://lcsc.com/product-detail/FFC-FPC-Connectors_JUSHUO-AFC01-S08FCA-00_C262657.html
Passives | guesstimate |  | 0.5 |  | 1 |  |  | 0.5 | 0.5
 |  |  |  |  |  |  |  | 0 | 0
 |  |  |  |  |  |  | Total USD | 9.484 | 12.984
 |  |  |  |  |  |  | Total GBP | 6.92332 | 9.47832
 |  |  |  |  |  |  | EC USD | 33194 | 45444 | EC | 3500 | Units
 |  |  |  |  |  |  | EC GBP | 24231.62 | 33174.12
Notes:
1. Jonty thinks he can get Würth to sponsor 687108182122
