emfcamp/TiDAL-Hardware/tilda6/manufacturing-data-expansion/expansion-bom.xlsx

expansion board
RD | Value | Desc | fp | Q | Notes | MN | MPN | DPN | DN | Price | EP | Avail | URL
J1 | Conn_01x08 |  | tilda6:XUNPU_FPC-05F-8PH20 | 1 |  | Xunpu | FPC-05F-8PH20 | C2856797 | LCSC | 0.06 | 0.06 | 12920 | https://lcsc.com/product-detail/FFC-FPC-Connectors_XUNPU-FPC-05F-8PH20_C2856797.html
