emfcamp/TiDAL-Hardware/tilda6/tilda6-printable-assembly.stl

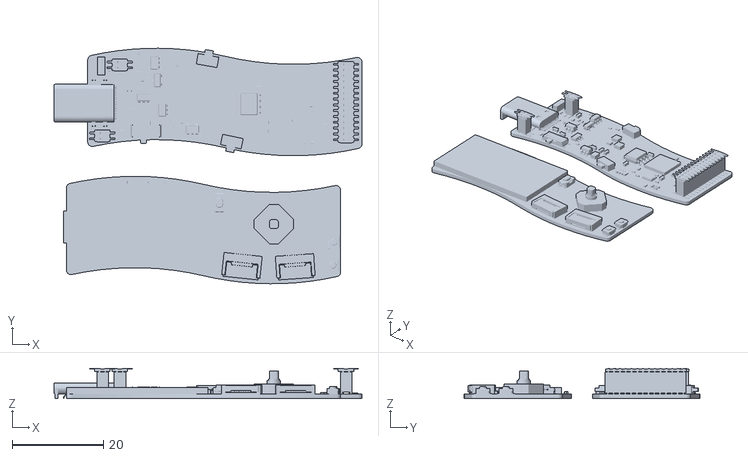
[picture p34: CAD file, 2022-02-13]
tilda6/tilda6-printable-assembly.stl
67.4 x 51.5 x 6.66
