emfcamp/TiDAL-Hardware/art/topboard-outline.FCStd

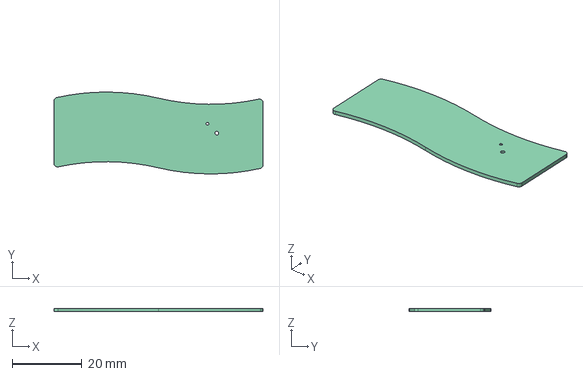
[picture p35: CAD file, 2022-04-15]
art/topboard-outline.FCStd
60.0 x 23.5 x 1.00 mm
