emfcamp/TiDAL-Hardware/tilda6/3d/24AT07A0100.step

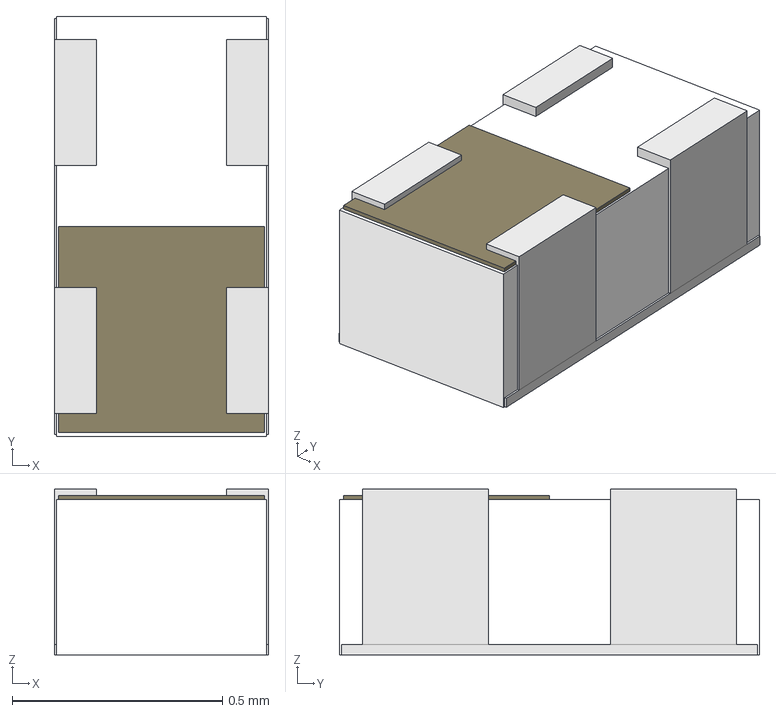
[picture p36: CAD file, 2022-04-16]
tilda6/3d/24AT07A0100.step
0.51 x 1.00 x 0.395 mm
