emfcamp/TiDAL-Hardware/tilda6/freecad/parts.FCStd

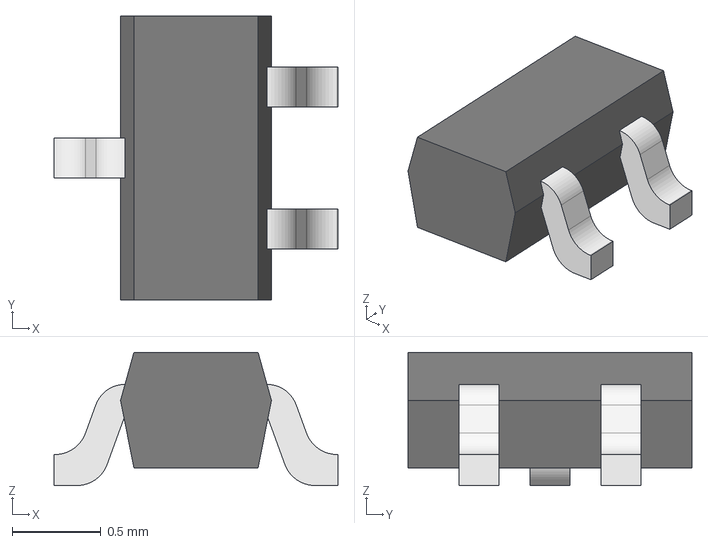
[picture p37: CAD file, 2022-02-13]
tilda6/freecad/parts.FCStd
1.60 x 1.60 x 0.75 mm
