emfcamp/TiDAL-Hardware/tilda6/3d/JST-SM02B-SRSS-TB.step

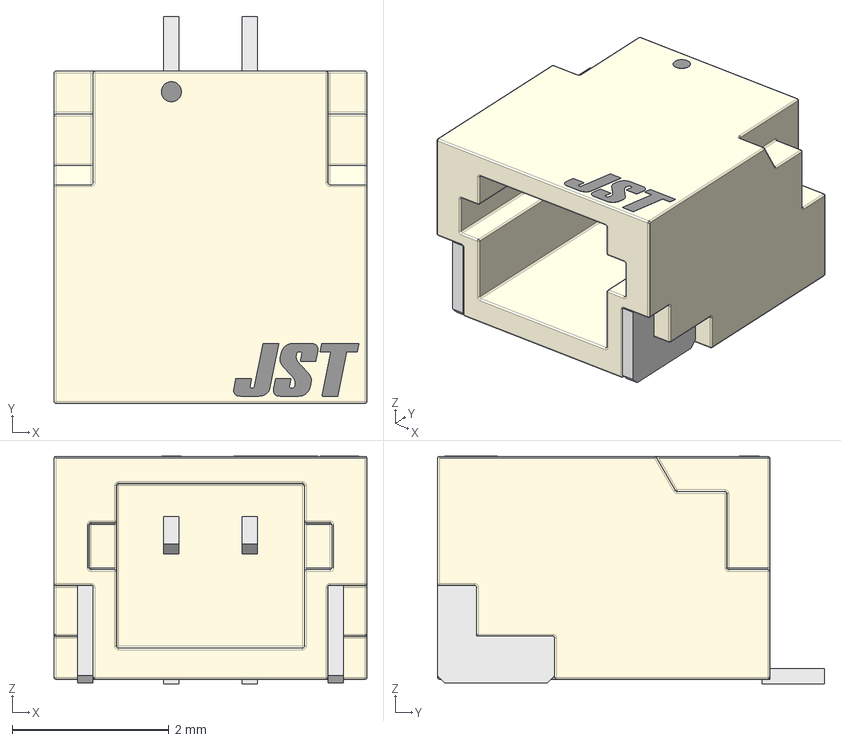
[picture p38: CAD file, 2022-04-01]
tilda6/3d/JST-SM02B-SRSS-TB.step
4.00 x 4.95 x 2.91 mm
base
terminals
logo
