emfcamp/TiDAL-Hardware/tilda6/freecad/TopPads_fd.step

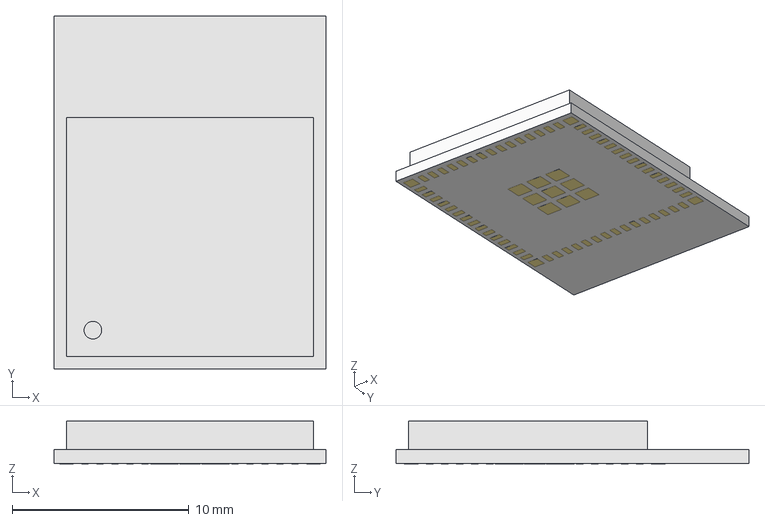
[picture p39: CAD file, 2021-08-28]
tilda6/freecad/TopPads_fd.step
15.4 x 20.0 x 2.41 mm
