emfcamp/TiDAL-Hardware/tilda6/3d/XUNPU_FPC-05F-8PH20.step

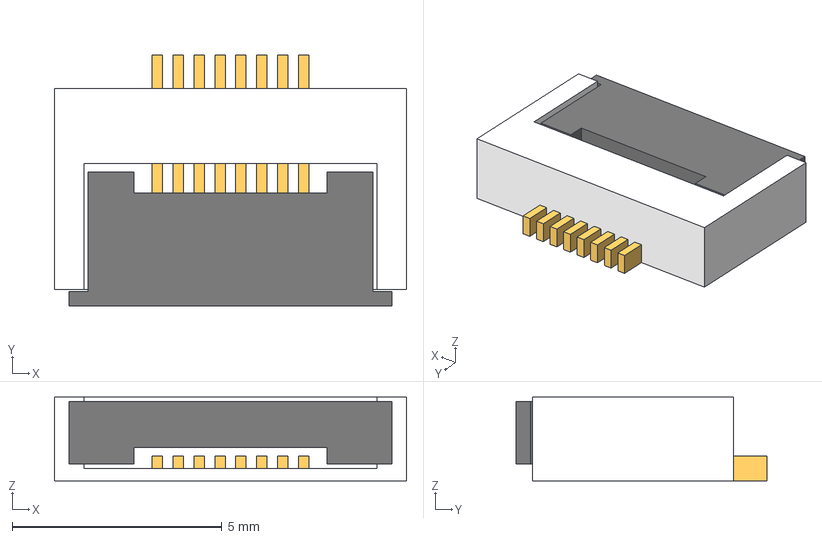
[picture p40: CAD file, 2022-02-13]
tilda6/3d/XUNPU_FPC-05F-8PH20.step
8.40 x 6.00 x 2.00 mm
