emfcamp/TiDAL-Hardware/tilda6/freecad/joystick.stp

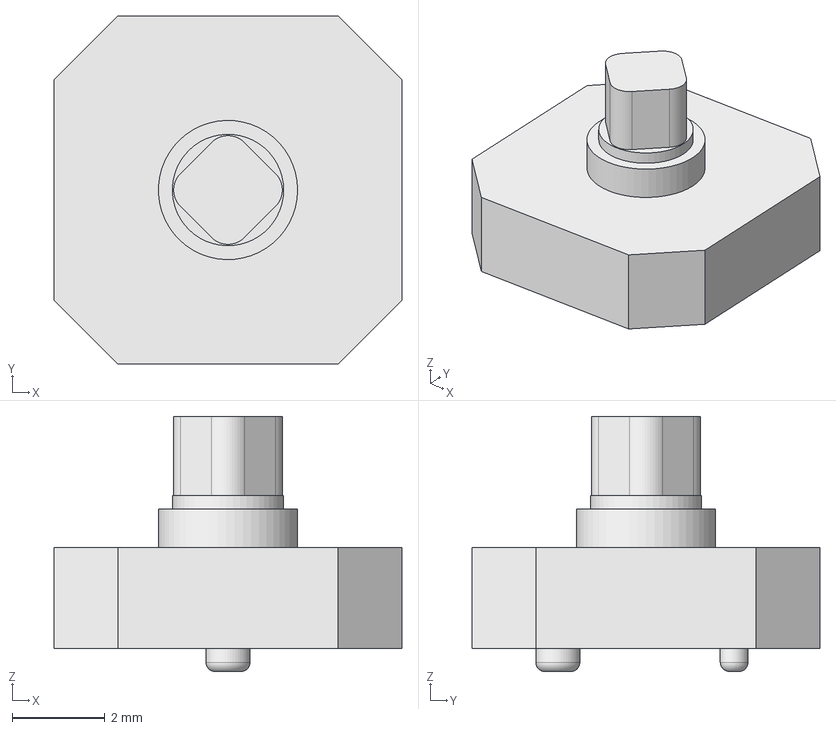
[picture p41: CAD file, 2021-08-28]
tilda6/freecad/joystick.stp
7.50 x 7.50 x 5.50 mm
