emfcamp/TiDAL-Hardware/tilda6/3d/battery-301730.step

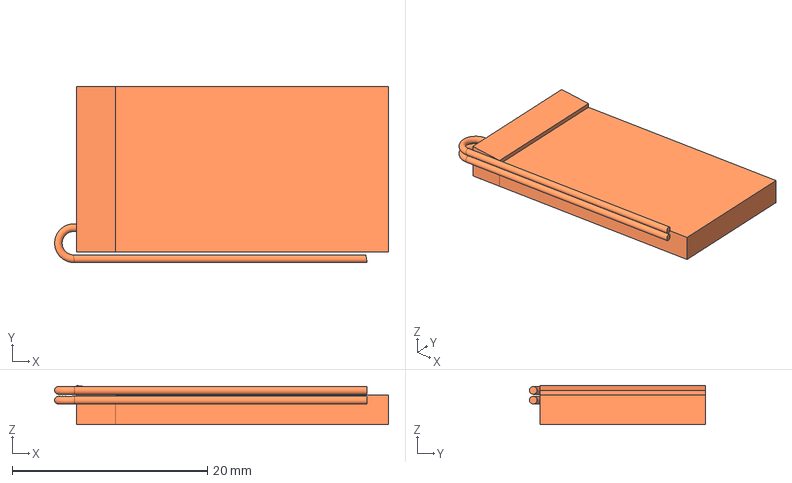
[picture p42: CAD file, 2022-02-12]
tilda6/3d/battery-301730.step
34.2 x 18.1 x 4.00 mm
