emfcamp/TiDAL-Hardware/tilda6/freecad/Fusion.stp

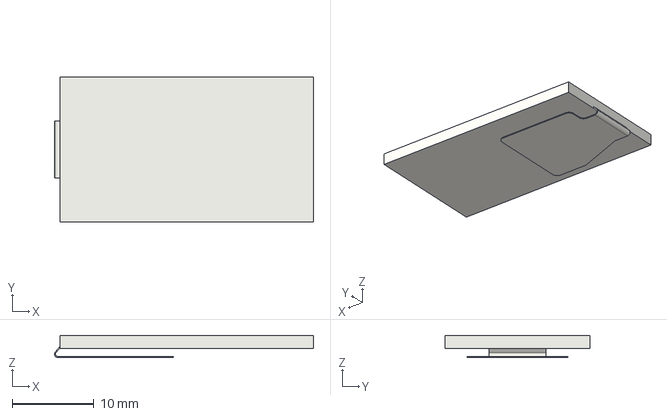
[picture p43: CAD file, 2021-08-28]
tilda6/freecad/Fusion.stp
31.7 x 17.7 x 2.73 mm
