emfcamp/TiDAL-Hardware/tilda6/3d/SOT-523.step

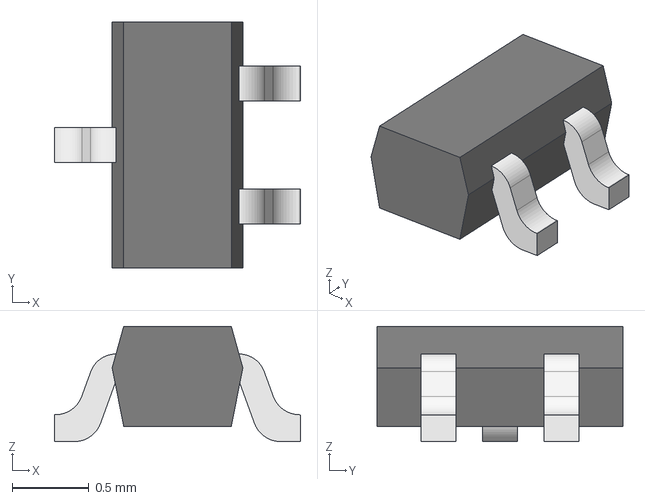
[picture p44: CAD file, 2022-01-30]
tilda6/3d/SOT-523.step
1.60 x 1.60 x 0.75 mm
