emfcamp/TiDAL-Hardware/tilda6/freecad/battery.FCStd

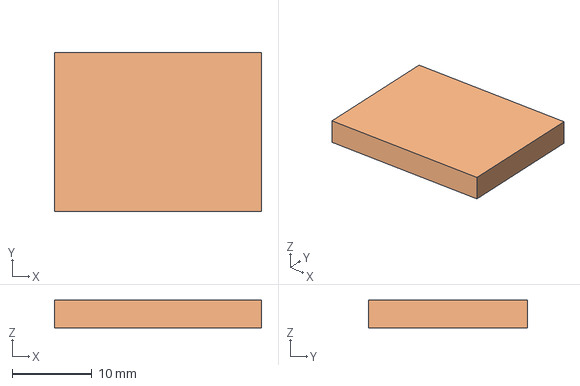
[picture p45: CAD file, 2021-08-28]
tilda6/freecad/battery.FCStd
26.0 x 20.0 x 3.50 mm
