emfcamp/TiDAL-Hardware/tilda6/3d/L2016.step

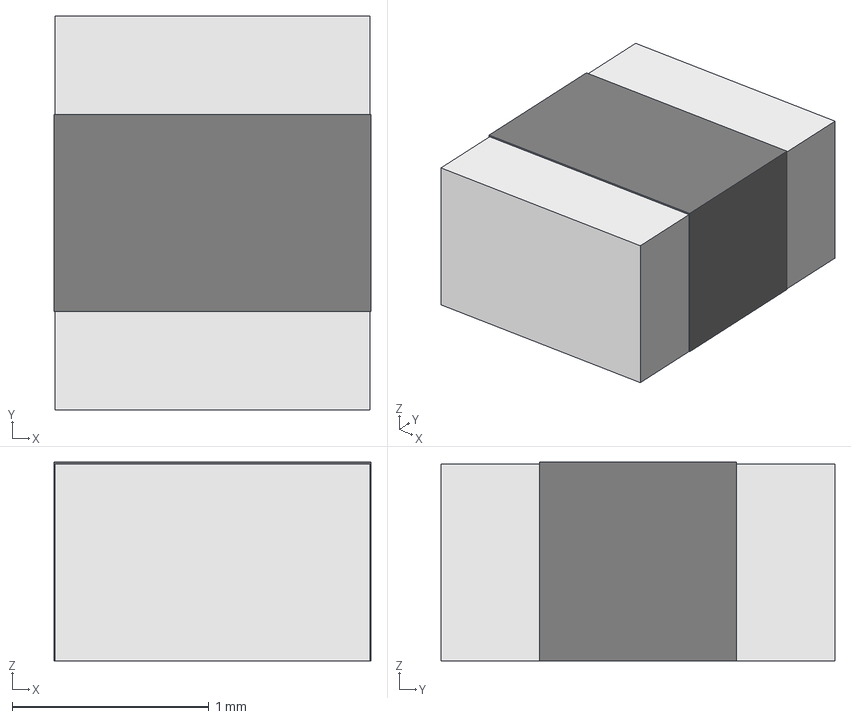
[picture p46: CAD file, 2022-01-30]
tilda6/3d/L2016.step
1.61 x 2.00 x 1.01 mm
