emfcamp/TiDAL-Hardware/tilda6/3d/A1006TL.step

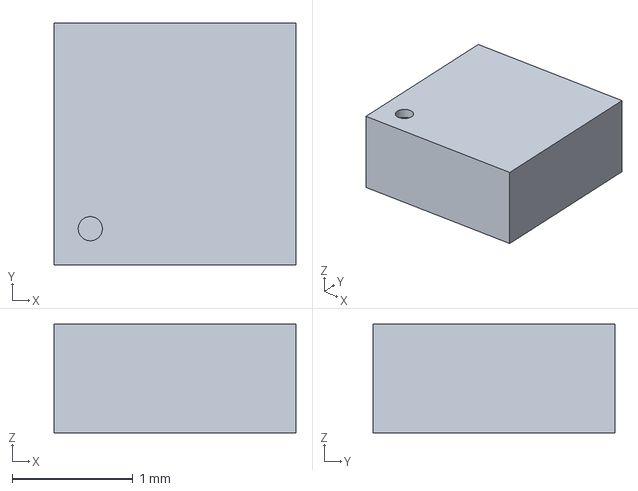
[picture p47: CAD file, 2022-01-30]
tilda6/3d/A1006TL.step
2.00 x 2.00 x 0.9 mm
