emfcamp/TiDAL-Hardware/tilda6/3d/SOT883.step

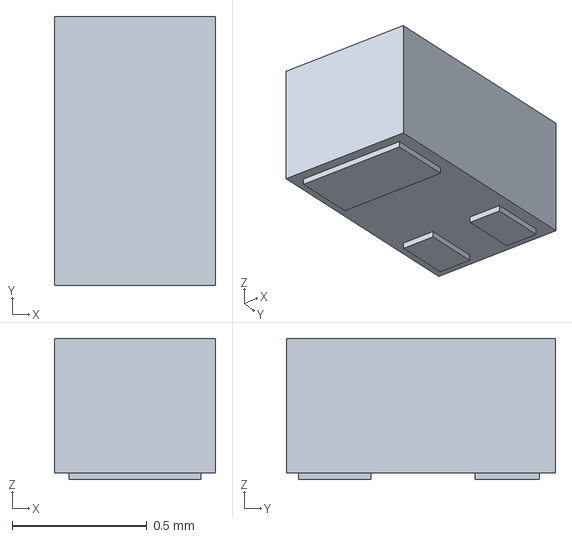
[picture p48: CAD file, 2022-01-30]
tilda6/3d/SOT883.step
0.6 x 1.00 x 0.525 mm
