emfcamp/TiDAL-Hardware/tilda6/3d/SK6812-SIDEA.step

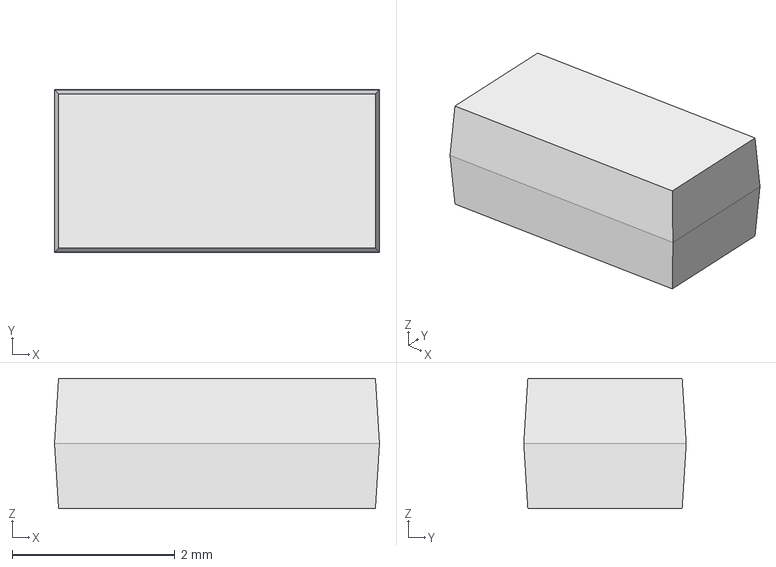
[picture p49: CAD file, 2022-01-30]
tilda6/3d/SK6812-SIDEA.step
4.00 x 2.00 x 1.60 mm
