emfcamp/TiDAL-Hardware/tilda6/3d/KMR231NGULCLFS.stp

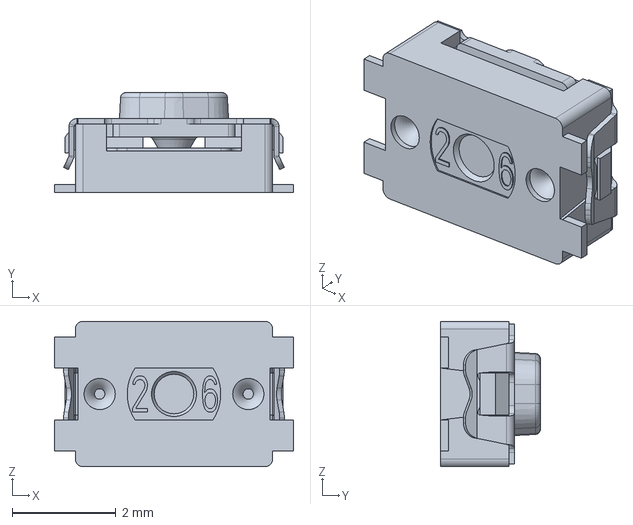
[picture p50: CAD file, 2022-01-30]
tilda6/3d/KMR231NGULCLFS.stp
4.60 x 1.92 x 2.80 mm
