emfcamp/TiDAL-Hardware/tilda6/3d/TS-1185EC.step

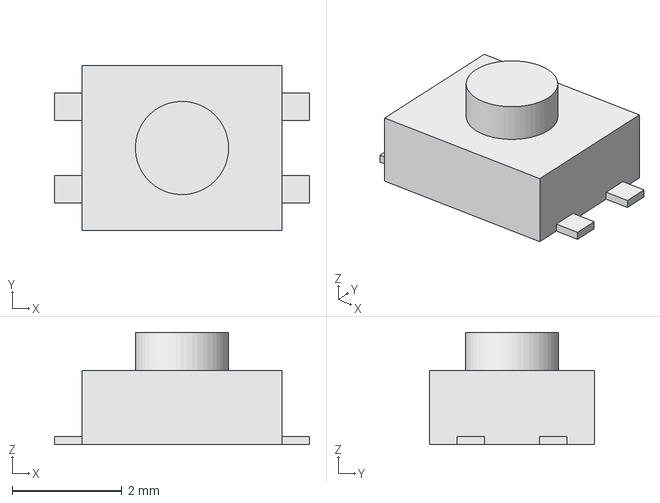
[picture p51: CAD file, 2021-08-28]
tilda6/3d/TS-1185EC.step
4.65 x 3.00 x 2.05 mm
