emfcamp/TiDAL-Hardware/tilda6/3d/1TS003B.step

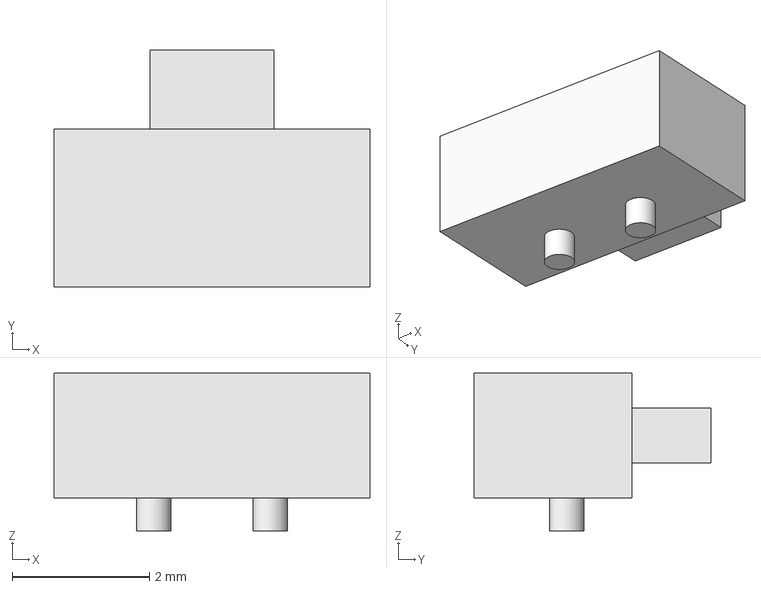
[picture p52: CAD file, 2021-08-28]
tilda6/3d/1TS003B.step
4.60 x 3.45 x 2.30 mm
