emfcamp/TiDAL-Hardware/tilda6/3d/fpc-0.5-8.step

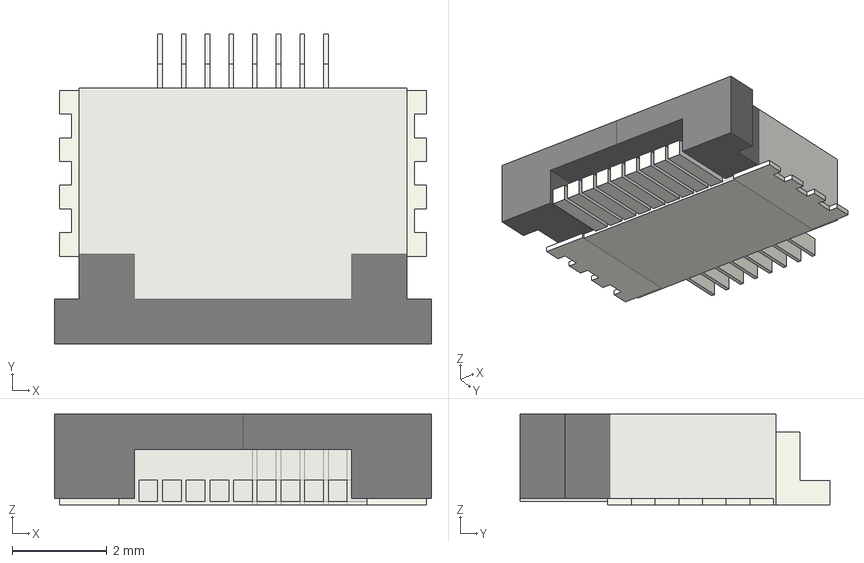
[picture p53: CAD file, 2021-08-28]
tilda6/3d/fpc-0.5-8.step
7.96 x 6.54 x 1.92 mm
