emfcamp/TiDAL-Hardware/tilda6/3d/utc009.step

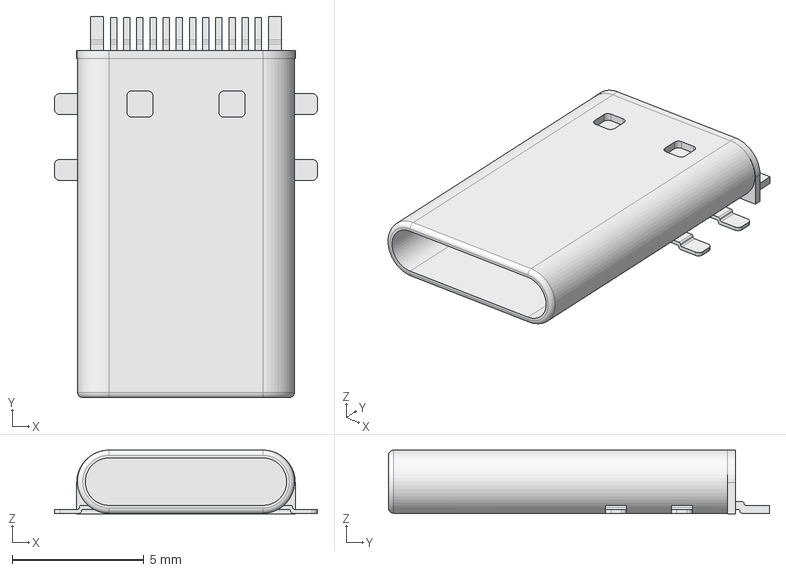
[picture p54: CAD file, 2021-08-28]
tilda6/3d/utc009.step
9.99 x 14.5 x 2.43 mm
