emfcamp/TiDAL-Hardware/(list of files, cad)

Other CAD files:
tilda6/board-geometry.FCStd
tilda6/freecad/Pad.step
tilda6/freecad/display.FCStd
tilda6/3d/ESP32-S2-MINI-1.step
tilda6/fpc-0.5-8.step
tilda6/freecad/1TS003B.FCStd
tilda6/freecad/SK6812-SIDEA.FCStd
tilda6/freecad/TS-1185EC.FCStd
tilda6/freecad/XUNPU_FPC-05F-8PH20.FCStd
tilda6/freecad/joystick.FCStd
