emfcamp/TiDAL-Hardware/(threads)

Thread 3 (2022-08-18):

Any case

Fran-Rg, 2022-08-18:
Is there any place selling cases and/or possibility to 3D print a case from any of the files in there?

kliment, 2022-08-18:
Yes of course! Our recommended case models are at https://github.com/emfcamp/tidal-docs/tree/main/3d-print-case

I am not aware of anyone selling them but I'm sure there's places and people that will take your money to print it for you.

Closed 2022-08-18.
