emfcamp/TiDAL-Hardware/tilda6/module/tilda6.pdf

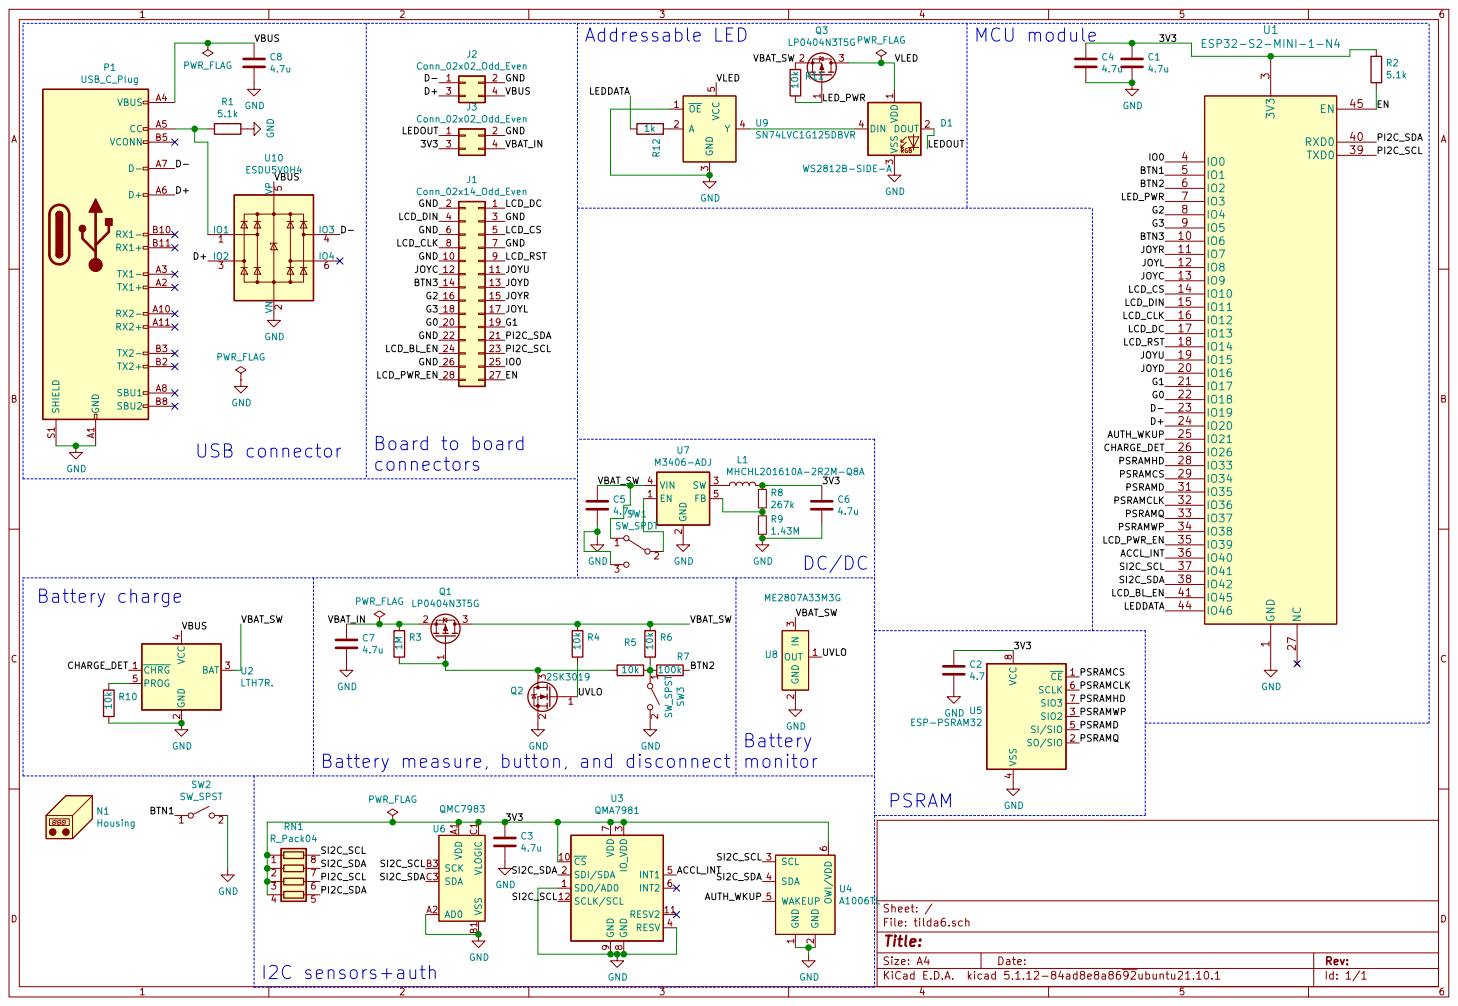
[picture p55: page 1]

2 SW 3 VIN 4 FB 5 U7 M3406-ADJ GND GND

8 U5 ESP-PSRAM32 SDO/AD0 1 CS 10 RESV2 11 SCLK/SCL 12 SDI/SDA 2 IO_VDD

4 SI/SIO 5 SCLK 6 SIO3 7 VCC

2 SCL 3 SDA 4 WAKEUP 5 OWI/VDD
