emfcamp/TiDAL-Hardware/tilda6/manufacturing-data-bot-board/tilda6_bot-assembly-diagram.pdf

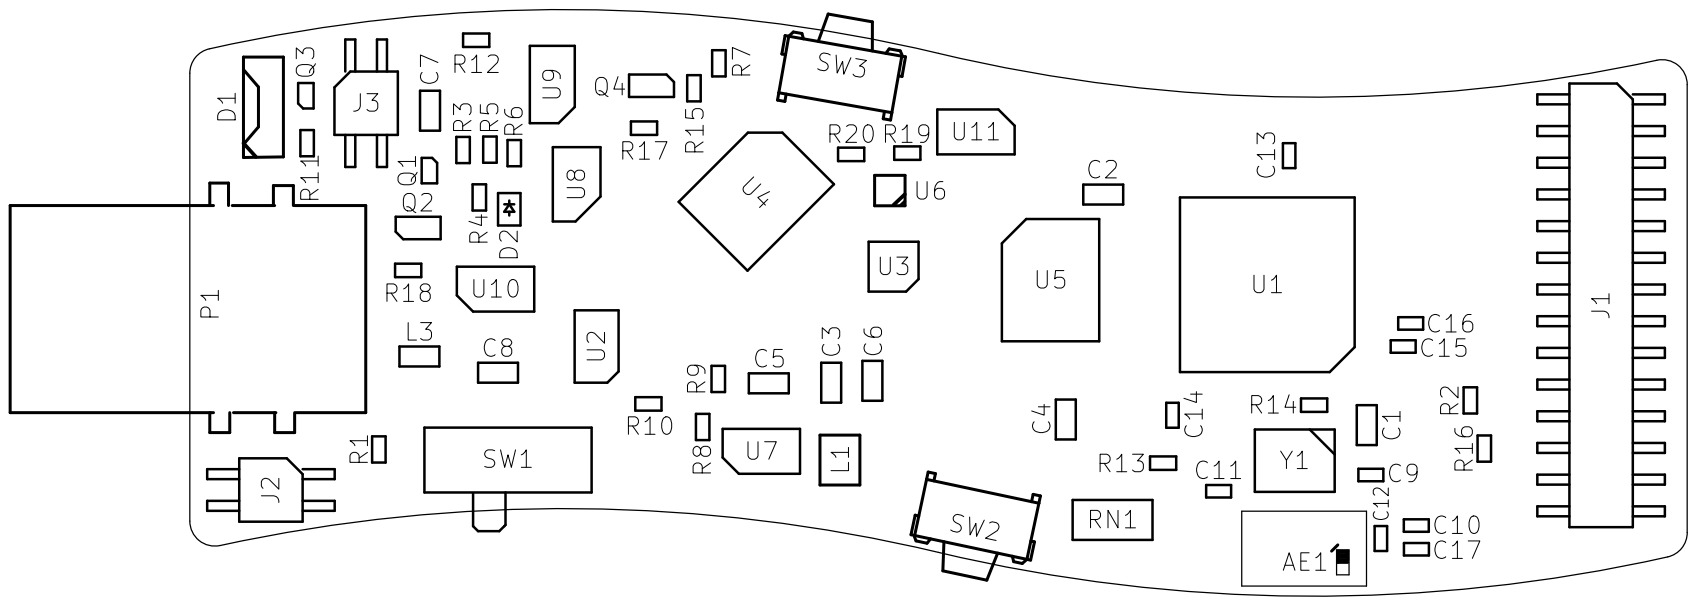
[picture p56: page 1]
