emfcamp/TiDAL-Hardware/datasheets/2108131730_Korean-Hroparts-Elec-K1-5202UA-02_C145900.pdf

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

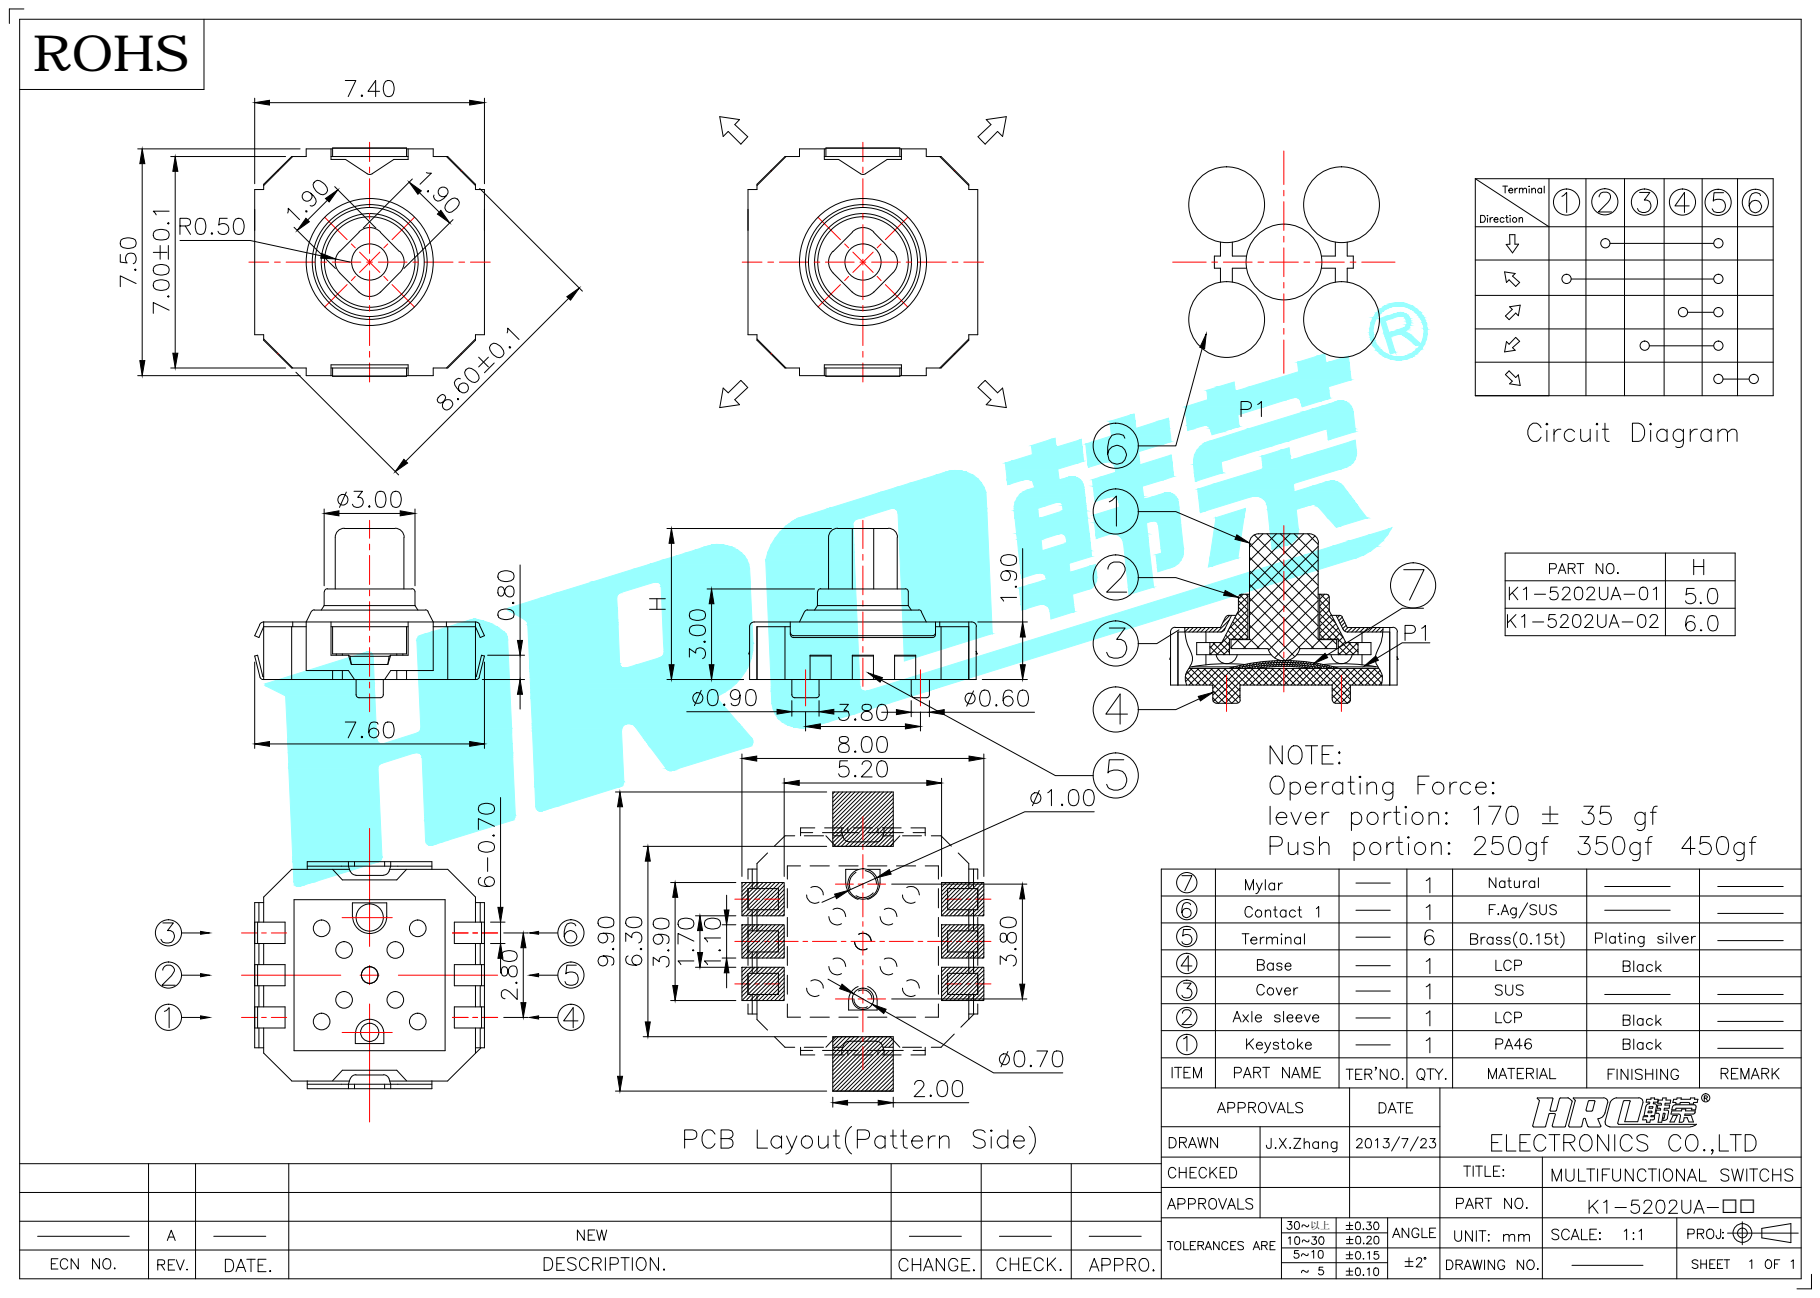
[picture p57: page 1]
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
