emfcamp/TiDAL-Hardware/(commit log)

2021-08-28 Add 3d models for buttons (thanks castawayc)
    [1TS003B.FCStd, 1TS003B.step, TS-1185EC.FCStd, TS-1185EC.step, tilda6.kicad_pcb, tilda6.sch]
2021-08-29 3d models for SK6812-SIDEA
    [SK6812-SIDEA.FCStd, SK6812-SIDEA.step]
2022-01-30 First full layout
    [KMR231NGULCLFS.stp, board-geometry.FCStd, tilda6-top.kicad_pcb, tilda6-top.sch, tilda6.kicad_pcb, tilda6.sch]
2022-01-30 Add castaway's side-LED 3d model to STEP outputs
    [tilda6-top.kicad_pcb, tilda6.kicad_pcb]
2022-01-30 Add SOT883 3d model
    [SOT883.step, tilda6-top.kicad_pcb, tilda6.kicad_pcb]
2022-01-30 Add remaining 3d models, fix L1 fp
    [A1006TL.step, L2016.step, QMC7983.step, SOT-523.step, tilda6.kicad_pcb]
2022-01-30 Change DC/DC to M3406-ADJ for lower quiescent current at low load
    [tilda6.kicad_pcb, tilda6.sch]
2022-02-09 Implement most of martling's recommendations: - power switch now controls DC/DC enable - top board caps changed from 1x4.7u to 1x1u+1x10n - top board edge via stitching - bottom board ground all arou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
    [tilda6-top.kicad_pcb, tilda6-top.sch, tilda6.kicad_pcb, tilda6.sch]
2022-02-09 Improve top board edge layout
    [tilda6-top.kicad_pcb]
2022-02-12 Add new tilda6-bot board with IC instead of module, and martling-compatible layout
    [battery-301730.step, tilda6-bot.kicad_pcb, tilda6-bot.sch, tilda6-top.kicad_pcb, tilda6-top.sch]
2022-02-12 Add silly text
    [tilda6-bot.kicad_pcb]
2022-02-12 Improve layout, add some additional parts as recommended by espressif HDG
    [tilda6-bot.kicad_pcb, tilda6-bot.sch]
2022-02-12 Move backlight control to IO0, put UVLO_TRIG on GPIO45
    [tilda6-bot.kicad_pcb, tilda6-bot.sch]
2022-02-12 Straighten a handful of traces for better ground coverage
    [tilda6-bot.kicad_pcb]
2022-02-12 Very small adjustment to switch orientation to better match board curvature
    [tilda6-bot.kicad_pcb]
2022-02-12 Move board with module into separate directory to avoid confusion
    [tilda6.kicad_pcb, tilda6.sch]
2022-02-13 Use correct footprint for top PCB FPC connector and add 3d model for it
    [XUNPU_FPC-05F-8PH20.FCStd, XUNPU_FPC-05F-8PH20.step, parts.FCStd, tilda6-top.kicad_pcb, tilda6-top.sch]
2022-02-13 Add 3d-printable assembly model
    [tilda6-printable-assembly.stl]
2022-02-14 Fix some part values
    [tilda6-bot.kicad_pcb, tilda6-bot.sch]
2022-02-14 Add BOM file
    [tilda6-BOM.xlsx]
2022-02-14 Implement martling's suggestions, add RF test port
    [tilda6-bot.kicad_pcb, tilda6-bot.sch]
2022-02-16 Swap out undervoltage monitor, replace topside switches with cheaper part
    [tilda6-BOM.xlsx, tilda6-bot.kicad_pcb, tilda6-bot.sch, tilda6-top.kicad_pcb, tilda6-top.sch]
2022-02-17 Add expansion pads to bottom of board
    [tilda6-bot.kicad_pcb, tilda6-bot.sch]
2022-02-18 correct assumptions about display flex curvature
    [tilda6-top.kicad_pcb, tilda6-top.sch]
2022-02-18 Add views of top and bottom side of top and bottom board
    [tilda6-top.kicad_pcb]
2022-03-07 Add some LCSC PNs to BOM, minor fix to some traces on top PCB
    [tilda6-BOM.xlsx, tilda6-top.kicad_pcb]
2022-03-14 fix package type in URL for A1006TL
    [tilda6-BOM.xlsx]
2022-03-14 Add URL for USB connector
    [tilda6-BOM.xlsx]
2022-03-14 Detail BOM with MPNs and DPNs, specify passives
    [tilda6-BOM.xlsx]
2022-03-31 Remove A1006, add ATECCx08A-SSHDA. Remove antenna connector, correct U8 fp
    [tilda6-bot.kicad_pcb, tilda6-bot.sch]
2022-03-31 Fix footprints for USB connector and side buttons.
    [tilda6-bot.kicad_pcb, tilda6-bot.sch]
2022-03-31 Move PSRAM to main SPI from SUBSPI
    [tilda6-bot.kicad_pcb, tilda6-bot.sch]
2022-04-01 Improve gnd flow around PSRAM. Make antenna manufacturable at 5mil spacing.
    [tilda6-bot.kicad_pcb]
2022-04-01 Improve top small switches fp
    [tilda6-top.kicad_pcb]
2022-04-01 Move screen solder pads to topside of top board, to make space for battery connector on underside.
    [tilda6-top.kicad_pcb]
2022-04-01 Add battery connector to top PCB
    [JST-SM02B-SRSS-TB.step, tilda6-top.kicad_pcb, tilda6-top.sch]
2022-04-01 Remove stray trace fragment from under battery connector
    [tilda6-top.kicad_pcb]
2022-04-01 Reduce paste coverage on display pads
    [tilda6-top.kicad_pcb]
2022-04-01 Slight correction to display position
    [tilda6-top.kicad_pcb]
2022-04-05 Fix phantom 2.7V problem in UVLO circuit, fix DC/DC voltage divider
    [tilda6-bot.kicad_pcb, tilda6-bot.sch]
2022-04-06 Add opamp to BTN2
    [tilda6-bot.kicad_pcb, tilda6-bot.sch]
2022-04-07 Flip battery connector pinout to match off the shelf batteries. Add USB connector breakout to top PCB.
    [tilda6-top.kicad_pcb, tilda6-top.sch]
2022-04-07 Increase paste volume on USB-C connector mechanical pads
    [tilda6-bot.kicad_pcb]
2022-04-07 Set battery measurement opamp gain to 1.665x
    [tilda6-bot.kicad_pcb, tilda6-bot.sch]
2022-04-07 Update board images with new layout
2022-04-08 Adjust pad geometry of USB connector per PCB manufacturer advice
    [tilda6-bot.kicad_pcb]
2022-04-11 Add measured s-parameter data for antenna matching.
2022-04-11 Add antenna measurements and matching network design.
2022-04-13 Update BOM. Add matching network values to bottom PCB.
    [tilda6-BOM.xlsx, tilda6-bot.kicad_pcb, tilda6-bot.sch]
2022-04-13 Add diode distributor page link to BOM
    [tilda6-BOM.xlsx]
2022-04-15 Add art
    [tilda6-bot.kicad_pcb, tilda6-top.kicad_pcb]
2022-04-15 Add freecad file with top PCB outline
    [topboard-outline.FCStd]
2022-04-16 Finalized art
    [tilda6-BOM.xlsx, tilda6-bot.kicad_pcb, tilda6-top.kicad_pcb]
2022-04-16 Add manufacturing data package for both boards
    [24AT07A0100.step, bottom-board-BOM.xlsx, top-board-BOM.xlsx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]
2022-04-16 Add assembly diagram and board views to manufacturing data
2022-04-17 Tidy up text on assembly drawing.
    [tilda6-bot.kicad_pcb]
2022-04-17 clean up silkscreen on reverse side of top board, regenerate assembly diagram
    [tilda6-top.kicad_pcb]
2022-04-18 Move on/off labels a bit away from edge. Generate production files for... production.
    [tilda6-bot.kicad_pcb, tilda6-top.kicad_pcb]
2022-04-20 Add expansion board
    [expansion-bom.xlsx, pcbgogo-expansion.kicad_pcb, pcbgogo-expansion.sch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]
2022-04-25 Modify board to match manufacturing constraints related to board shape and panelization. No significant visual or functional changes.
    [tilda6-bot.kicad_pcb]
2022-04-25 Add schematic for expansion board
    [pcbgogo-expansion.sch]
